yousef-chitani/Type_0_CNC/docs/decisions.md

# Decision log

| # | Decision | Reason |
|---|---|---|
| D-01 | Fixed gantry, table moves in Y | Stiffest layout for EG. Same as Bootstrap Bill |
| D-02 | Cast the EG at home | Cost |
| D-03 | Target accuracy ±0.02 mm | Realistic for DIY EG with good alignment |
| D-04 | ISO20 taper | Matches the chosen spindle. Light holders, compact rack |
| D-05 | Rack lives behind the gantry | Leaves the work area clear and away from chips |
| D-06 | Rack comes in low, through the table opening | During a tool change the table moves forward out of the way and the rack slides in under the spindle. No window in the beam, so Z stays short. X travel stays at the work size. Any Y overrun is to be checked in the layout (it depends on rack depth) |
| D-07 | Mist / MQL coolant, full enclosure | Works for alu and steel, with less mess than flood |
| D-08 | Z travel can drop below 250 mm | Small parts. A shorter Z overhang is stiffer. Value set in D-09 |
| D-09 | Z travel 150 mm, about 180–200 mm clearance | Fits a vise, a part and a long tool. Short overhang stays stiff. Enough lift to clear the rack forks |
| D-10 | C7 rolled ballscrews with preloaded double nuts (DFU) | Fits the budget. About ±0.05 mm per 300 mm, brought to ±0.02 mm with a mapping run and LinuxCNC screw compensation |
| D-11 | HGR20-pattern rails, Z1 preload | Plenty for this size. Rails will be checked and sorted on arrival |
| D-12 | Rail seats made with a self-leveling epoxy layer over cured EG, rails bolted to cast-in inserts | Cheap and good to about 0.01–0.02 mm if done carefully. No reference surface needed |
| D-13 | SFU1605 ballscrews, preloaded DFU nuts, on all three axes | Fine resolution and high thrust for steel. One screw and nut type for all axes. Rapids about 6–7 m/min, enough for small parts |
| D-14 | Direct drive through disc or bellows couplings | No backlash and nothing to tension |
| D-15 | NEMA 24 closed-loop steppers, about 4 Nm, on all axes | Margin for the heavy table and for steel |
| D-16 | Z motor has a built-in 24 V holding brake | Stops the spindle drifting down with the power off. Simplest and safest option |
| D-17 | Rack holds two rows of 4 ISO20 pockets at about 60 mm pitch | 4 × 60 mm fits within the 250 mm X travel. Keeps all 8 tools without widening the machine |
| D-18 | Rack driven by a small stepper on a screw or belt, run as a 4th joint in LinuxCNC with a home switch | Exact stop for each row and adjustable in software. Doesn't depend on air pressure |
| D-19 | Tool-length sensor on the rack carrier | Protected from chips and takes no table space. Measures each tool right after pickup |
| D-20 | Y: 2 rails about 220 mm apart, 2 carriages per rail, about 150 mm apart along Y | Wide stance resists cutting moments. Room for the screw between the rails |
| D-21 | X: 2 rails on the gantry front face, about 150 mm apart vertically, screw between them | Only one face to level-pour. Simple and proven on DIY gantries |
| D-22 | Z: rails on the moving spindle plate, blocks fixed on the X saddle | Compact, light saddle. Fine for 150 mm of travel |
| D-23 | Table: 25–30 mm aluminium tooling plate with a threaded M6/M8 grid, about 320 × 320 mm | Light, cheap, can be surfaced on the machine. Suits small fixtured parts |
| D-24 | Separate EG castings (base; gantry), bolted and epoxy-bonded | Smaller molds, each about 60–150 kg, so easier to vibrate and handle. The gantry can be squared to the Y rails before bonding |
| D-25 | Molds made of melamine-faced MDF/ply with packing tape, wax and PVA release | Cheap, flat, easy to cut. Good for one-off castings |
| D-26 | Graded aggregate mix with about 10–12% epoxy by weight | Kiln-dried quartz gravel, sand and fine filler following a packing curve, with low-viscosity casting epoxy. Less epoxy means less cost, less heat and less shrinkage |
| D-27 | Compact on a sprung vibration table driven by unbalanced motors | Even compaction, no voids, reusable for every casting |
| D-28 | Rail and pad fixings are steel insert bars (40×10 mm, tapped), bolted to the mould floor during the pour | Holes stay in line at the rail-bolt pitch and can't drift during vibration |
| D-29 | Gantry joins the base with M12 bolts plus a grout layer: shim the gantry square, inject epoxy grout, tighten after cure | Square and stiff, and the joint isn't stressed while it cures |
| D-30 | Solid castings (no cores) | No documented DIY example of large foam cores was found. Solid is the most proven. Cost: about 315 kg and about 41 kg of epoxy. Curing heat must be managed (see eg-moulds.md) |
| D-31 | Mesa 7i76EU (Ethernet) as the only interface board | 5 step/dir (4 used, 1 spare), 32 inputs and 16 outputs cover the about 20 inputs and 10 outputs needed, with room to spare |
| D-32 | Spindle VFD controlled over Modbus RS-485 (via the 7i76EU's RS-485 port, D-58) | Speed command plus readback of actual speed, faults and load. Lets LinuxCNC confirm the spindle has stopped before releasing a tool |
| D-33 | Water-cooled spindle, with a flow switch interlocked into LinuxCNC | Quiet and doesn't stir up dust in the enclosure. The spindle can't run without coolant flow |
| D-34 | x86 mini-PC with an Intel network port dedicated to the Mesa board | Reliable timing, cheap used |
| D-35 | Hardwired e-stop: buttons and the Mesa watchdog run through a safety relay that drops a contactor, cutting drive power and the VFD run signal | Still stops if the PC or software crashes. The Z brake engages when power drops. LinuxCNC only reads status |
| D-36 | One 48 V DC supply (about 10 A) for all 4 stepper drivers | Keeps torque up at speed. The rack driver must accept 48 V |
| D-37 | Electrical cabinet built into the stand, underneath the machine | Owner's choice: compact. Mitigations: sealed steel box with a sloped drip lip above it, filtered fan blowing air in (keeps dust and mist out), raised off the floor, away from the coolant drain, VFD mounted at the top with heat vented clear of the drives, door reachable from the front |
| D-38 | CW-3000-style radiator unit for the spindle water loop, using its flow alarm output for the interlock | Plenty for 2.2 kW, cheap. Confirm the model has a flow alarm output before buying |
| D-39 | Spindle: Jianken JGL-80/2.2R24-20 (24,000 rpm, 400 Hz, 220 V, ISO20, water-cooled), with clamp/unclamp sensors | About 0.87 Nm vs about 0.70 Nm for the R30 version, so about 25% more torque at every working speed. Better for steel and brass. Sources: [Jianken manual (LinuxCNC forum)](https://forum.linuxcnc.org/media/kunena/attachments/27367/OperationManual2019.pdf), [Amazon listing](https://www.amazon.com/LVSEDTAL-JGL-80-2-2R24-20-24000rpm-Spindle/dp/B0F5HKDVV4) |
| D-40 | ISO20-ER16 tool holders (8) | Owner's choice: cutters up to 10 mm |
| D-41 | Z motor: StepperOnline 24HS34-5004D-E1000-B280 (3 Nm closed-loop with 2.8 Nm 24 V brake) on a CL57T driver | Same frame, maker and driver as X and Y. 3 Nm is plenty for Z: holding the spindle needs only about 0.1 Nm through a 5 mm lead |
| D-42 | Precision level 0.05 mm/m (Dasqua 200 mm, £68.50) instead of 0.02 mm/m (£333.72) | The rail seats level themselves in one linked pour. The level only sets the casting and stand roughly level. Saves £265.22 |
| D-43 | Prefer collecting materials in person from B&Q (Nissan Qashqai) | Owner's preference: avoids delivery costs. Aggregates must still be clean and dry |
| D-44 | Molds from plain 18 mm MDF (Wickes, 3 sheets), faces and edges sealed, then wax + PVA | Saves £286.20 over the melamine 5-pack |
| D-45 | Fine aggregate: B&Q kiln-dried sand 2 × 25 kg, sieve-checked | Saves £152.42. Already dry and washed |
| D-46 | Coarse and medium aggregate: washed, kiln-dried resin-bound quartz from GCL (2-5 mm and 1-3 mm) | Graded and dried for resin use. Horticultural grit and the Rugeley collection were declined. Pallet delivery cost to Swansea still to confirm |
| D-47 | Build in two stages. Stage 1: frame, motion, spindle, electronics, air, stand: a working mill with manual tool changes (air release button). Stage 2: tool rack and its drive, enclosure, mist, door interlock | Spreads cost and gets the machine cutting sooner. The frame already includes the rack zone and inserts, so stage 2 bolts on |
| D-48 | Layout as a parametric CadQuery script producing STEP + dimensioned SVG views | One set of numbers drives the model, drawings and cut lists |
| D-49 | Table top about 950 mm above the floor | Comfortable standing height; cabinet fits under |
| D-50 | Y motor at the front, X motor on the right | Keeps the rear rack zone clear |
| D-51 | Design workholding height about 100 mm (small precision vise) | Sets Z clearance and gantry opening height |
| D-52 | Layout draft 1 accepted as the working basis: Y travel 395 (250 + 145 for the tool change), base 970 × 660 × 180 | Generated from cad/type0_layout.py, see layout.md |
| D-53 | Electrical cabinet inside the stand, max 440 mm tall: prefer 600 W × 400 H × 200 D (fallback 400 × 400 × 200) | Fits between the stand rings. The wider box leaves room for VFD heat and wiring |
| D-54 | Stand from 60 × 60 × 3 box section with diagonal bracing (about 11.9 m) | Ample for about 400 kg when braced. Cheaper and lighter than 80 × 80 × 5 |
| D-55 | Rails from Kaiyade (3 kits in one order), ballscrews X 450 / Y 550 / Z 350 from METALWORK, 60 × 60 × 3 steel from eBay (6 × 2 m), 600 × 400 × 200 galvanised cabinet | Cheapest full matches without per-shopper deal limits |
| D-56 | Cast a Y-screw channel about 70 × 25 mm into the base between the Y rails | The DSG16H housing hangs 10 mm below the base top when bolted under the table |
| D-57 | Budget: Stage 1 £5,300, Stage 2 £600 | Priced Stage 1 is £4,807 plus the Mesa board, spindle import VAT and aggregate delivery. Margin for shipping and surprises |
| D-58 | Owner supplies: mini-PC, monitor/keyboard/mouse, 3D-printed ISO20 forks. No 2nd NIC, no USB-RS485 adapter | PC stays offline, so the onboard Intel NIC runs the Mesa. VFD Modbus runs on the 7i76EU's own RS-485 port |
| D-59 | All power supplies DIN-rail Mean Well: 48 V (≥ 10 A), 24 V (HDR-150-24), plus a low-wattage 5 V | Saves cabinet space. Mounts on the same DIN rail |
| D-60 | Mesa 7i76EU at €309.31 (owner-confirmed) | Owner's price check |
| D-61 | Moulds: 1 B&Q MDF sheet (£28) for both floors (sealed + coated), 2 B&Q white gloss panels (£38.97 each) for walls and plug. Replaces D-44 | No seam in the precision floor face. Gloss walls need no sealing |
| D-62 | Owner orders the spindle direct from Jianken. The Mesa £257.74 already includes import VAT (not yet bought) | Owner action |
| D-63 | Aggregates: GCL washed kiln-dried quartz 2-5 mm (6 × 25 kg) for coarse. Hancock & Brown kiln-dried 0-1 mm sand (8 × 20 kg) for medium/fine. H&B limestone dust (dried) for filler. Replaces D-45, D-46 | Only the filler needs drying. Ready-to-use coarse. Local collection for the sand |
| D-64 | Filler: pottery whiting 25 kg (Valentine Clays, £20.42) instead of limestone dust | Bought dry, so no oven drying. Cheaper than silica flour and less hazardous to breathe |
| D-65 | Cuts: DIY vibrator, DIY temperature logging, MDF for mould walls (2 sheets total), DIY spindle cooling loop, cheaper stand | Owner's choices to reach about £4,000 |
| D-66 | Three phases. **Phase 1:** frame, motion, electronics, 2.2 kW water-cooled ER20 spindle (manual tool changes). **Phase 2:** Jianken ISO20 ATC spindle + holders, air system, mist, enclosure. **Phase 3:** tool rack, its drive, forks. Replaces D-47 | Spreads the cost. ER20 and ATC spindles share the 80 mm clamp, VFD and cooling loop |
| D-67 | UHPC frame rejected after costing: IN2 €67.50 ex VAT / 25 kg (11.7 L) needs about 13 bags (about €877). Polcrete about £45.60 / 20 kg (about 16 bags, about £730). Epoxy granite stays | Not cheaper in the UK at retail (Bootstrap Bill's about 50 CAD bags are Canadian prices) |
| D-68 | Budget: Phase 1 ≤ £4,000. Phases 2 and 3 budgeted later. Replaces D-57 | Owner target |
| D-69 | Phase 1 replacements: Wanhongcnc 2.2 kW ER20 spindle £150.59; ER20 collets + spanner £34.49; 24 V DIY cooling loop £104.77; stand from 8 m of 60 × 60 × 3 (no lower ring) £136.00 | Budgeted at normal (non-deal) prices. Phase 1 total £3,638.39 |
| D-70 | Phase 1 spindle from a known maker only: Jianken JGD-80 2.2 kW ER20, quoted together with the ATC spindle. Replaces the Wanhongcnc choice in D-69 | Unknown makers risk poor runout |
| D-71 | **Scale-down (v2):** upstairs flat, pieces ≤ 40 kg, total about 150 kg on anti-vibration feet, work area 200 × 200 × 150, coolant only inside an enclosure, timber bench made by the owner. Frame stays cast epoxy granite (no welded frame: weld stress) | Owner must be able to move out and keep it indoors |
| D-72 | If ATC is added, the rack (2 × 4) bolts to the table's +X side: table Y travel selects the pocket, spindle X travel extends by about 140 mm. No extra Y travel | Keeps the Y spine short and under 40 kg |
| D-73 | Portal legs span only the table (opening 320). Beam overhangs about 160 mm past the right leg. The ATC (if added) is an independent **ferris wheel**, 8 pockets, about Ø178, turning in the Y-Z plane beside the right leg, with the top pocket as the pickup. Replaces D-72 | Narrower, lighter portal. No rack on the table. X travel about 380 (200 work + reach) |
| D-74 | If the portal is over 40 kg, use capped PVC pipe cores in the beam (2 × 50 mm: about 34 → about 29 kg) | Documented DIY method (owner choice) |
| D-75 | v2 model accepted: castings 36.2 / 15.6 / 29.0 kg (80.8 kg). Travel X 380 / Y 200 / Z 150. Rails X 560, Y 400, Z 350. Screws X 550, Y 400, Z 350. Bench top 785 mm. Joints and wheel mount in v2-design.md | Rev B approved by owner |
| D-76 | Spine and rear foot cast as **one T-shaped base**, about 52 kg (2-person carry). Frame = 2 castings: base + portal | Owner: 2 people can carry it upstairs. Removes the only frame joint |
| D-77 | Vibration table: 1–2 old tyres as springs, a stiff board, and a motor with an unbalanced shaft. Replaces the vibration motors and rubber feet | Owner's method: cheap and proven |
| D-78 | Phase 1 spindle: **G-Penny 2.2 kW ER20 water-cooled kit** (£217.39) with Huanyang VFD, clamp, pump and collets. Replaces the Jianken JGD-80 (D-70) and the separate VFD, clamp and 24 V pump | Known maker, runout 0.005 mm stated, P4 angular-contact bearings, LinuxCNC has a Huanyang driver |
| D-79 | Work area **400 × 250**, Z 150 (fits 75% keyboards with room for fixtures). Table 460 × 330 × 25. Travel X 570 (incl. ATC reach) / Y 250 / Z 150 | Owner: wider range of work |
| D-80 | Y rails 280 mm apart on a 320 mm-wide spine (block pitch 150). Base about 72 kg, portal about 34 kg, frame about 106 kg | Table overhang about 90 mm per side instead of 140 |
| D-81 | Base mass accepted for now. Owner will run FEA later to find where material can be removed (ribs, cores) | Owner |
| D-82 | **Vendor policy:** no eBay. Use as few vendors as possible. Prefer B&Q and Screwfix (local), then RS Components. Target vendors: RS (all electrical, fixings, small metal, measuring tools), Screwfix + B&Q (building and casting consumables), Easy Composites (all epoxy + release), AliExpress (rails, screws, spindle kit, couplings, collets), StepperOnline (motors), Mesa, Aluminium Warehouse, aggregates | Owner: fewer baskets, local collection |
| D-83 | Threaded rod and nuts, conduit/tube and packing tape from AliExpress (not Screwfix). Any vendor swap that costs much more than the current price (more than 10% or £5) must be flagged before accepting | Owner: consolidation must not add a large premium |
| D-84 | Vendor consolidation applied (price check 8, logged in to AliExpress). Accepted premiums: Schneider XPSAC5121 safety relay (+£53.71), screened cables from AliExpress (+£21.95), RS cabinet 600 × 400 (+£43.09). Rejected: B&Q flat bar (keep The Metal Store £36), stainless M12 rod (price zinc at Screwfix). Level from AliExpress £32.94. 24 V PSU stays StepperOnline. E-stops 2 NC for the dual-channel relay. Epoxy: GlassCast 50 PLUS from Easy Composites | Owner choices on the price check 8 premiums |
| D-85 | Price check 9 applied: Screwfix BZP M12 rod 5-pack + nuts; AliExpress brass flow switch G1/4 (NO, 1.5–3 L/min); 8 mm ID braided PVC hose (B&Q marketplace); twinwall polycarbonate window (owner); RS push-in fittings; AliExpress shaft + KFL004 bearings; 5th LJ12 sensor added to E10. No eBay left | Last non-eBay sources |
| D-86 | Phase 3 (ATC wheel) merged into Phase 2. Now two phases: **Phase 1** working mill (manual ER20), **Phase 2** ATC spindle, air, mist, enclosure and the tool wheel. Replaces the phase split in D-66 | Owner |
| D-87 | Enclosure: 12 mm MDF box on the bench around the machine (not touching the castings), no bottom. Internal 880 × 930 × 742, outside 904 × 954 × 754. Top-hinged front door (622 high) above a 120 mm fixed strip; 560 × 380 twinwall window low in the door so the table and spindle tip are visible. 2 MDF sheets. Cable/hose slot with brush strip low in the back | Owner choices: top-hinged door, sits on bench, window in door |
| D-88 | Enclosure window: 4 mm solid clear polycarbonate 600 × 420 from plasticsheets.com, £29.87 delivered (+£5.88 vs twinwall). Replaces the twinwall in D-85 | Clear view, and 4 mm resists flying chips better than 3 mm |
| D-89 | Enclosure MDF from B&Q (12 mm, £23 per sheet × 2) instead of Wickes | One fewer vendor; cheaper |
| D-90 | Phase 1 runs 4 Jan 2027 → 22 Jul 2027 at about 5 h/week, built in the shed. Done = machine moves under LinuxCNC. Orders spread in 5 waves. Castings in April–May (≥ 18 °C cure). See phase1-schedule.md | Owner timeline |
| D-91 | Electrical design (docs/electrical.md): 13 A plug; 2 e-stops (bench front + cabinet door, 2 NC each, dual channel); home switches + soft limits (no hard limits); spindle on Modbus RS-485 only (7I76EU TB3, W6 termination off); 24 V supply powers the Mesa field + logic, never switched; one Mesa output enables all 3 drives; 5 V PSU shelved; DIN interface relay (24 V coil) for the 220 V pump | Owner answers + 7I76EU manual |
