yousef-chitani/Type_0_CNC/docs/price-check-task-9.md

# Price check task 9: last lines without a non-eBay source

**Project:** Type 0 CNC. Buyer in **Swansea, UK**. **Vendor policy (D-82/D-84):** no eBay. Use **only these vendors**, in this order of preference: **Screwfix, B&Q, RS Components, AliExpress, Easy Composites, StepperOnline, Aluminium Warehouse** (all already in the order). Do not add a new vendor unless nothing fits, and say so if you must.

## Rules
1. Only record prices you can **see on a live product page**. Never estimate or convert.
2. Record the price exactly as listed, VAT basis, pack size, shipping and delivery estimate. Screwfix and B&Q: stock and click & collect at the Swansea stores.
3. **AliExpress:** ask the person to log in themselves first, and wait. Never type, read or store their password or codes. Read prices logged in.
4. Do not add to basket, check out, buy or contact sellers. If a page asks for a human check, ask the person.
5. Compare each new all-in price with **Current** and report the delta: **OK** (≤ 10% or £5 above), **PREMIUM** (more, give the cheapest alternative too), **SAVING** (cheaper).
6. The product must match the spec. Say so if it only partly matches.

## Phase 1

| ID | Item | Spec | Current |
|---|---|---|---|
| F08 | M12 threaded rod + nuts | **Zinc-plated** M12 studding, 2 × 1 m, plus about 20–50 M12 nuts (Screwfix first) | none (old eBay price £28.74; stainless AliExpress £57.08 was rejected) |
| S05a | Coolant flow switch | **With switch contacts** (closes on flow), suits **8 mm** hose or 1/4"–1/2" BSP, switches at about 1–3 L/min, contacts rated for 24 V DC signal | none (old eBay £11.99) |
| S05b | Coolant tube | Silicone or PVC tube **8 mm ID** (about 11–12 mm OD), 5 m, for 8 mm barbs | none |

## Phase 2–3

| ID | Item | Spec | Current |
|---|---|---|---|
| N02 | Enclosure window | 4 mm clear polycarbonate, about 600 × 600 mm (B&Q/Screwfix sheet first) | £31.93 (eBay) |
| P06 | Push-in pneumatic fittings | 8 × straight 6 mm tube to 1/8" BSP male, 4 × straight 8 mm tube to 1/4" BSP male | £34.12 (eBay) |
| A07 | ATC wheel shaft + bearings | Ø20 mm steel shaft 150 mm (precision or bright), + 2 × UCFL204 / KFL004 2-bolt flange bearings, 20 mm bore | £29.49 (eBay) |
| A09 | Index sensor | M12 inductive, PNP NO, 24 V (LJ12A3-4-Z/BY or equal) | £4.99 (eBay). Note: E10 already buys this exact sensor on AliExpress: add 1 to that line if same price |

## Reply block

```
ID | vendor | price as listed (currency, VAT basis) | quantity it covers | stock / collect / shipping | product URL | all-in £ | current £ | delta (OK / PREMIUM / SAVING) | notes
```
Finish with the total for the Phase 1 lines and the total for the Phase 2–3 lines.
