yousef-chitani/Type_0_CNC/docs/price-check-task-7.md

# Price check task 7: parts resized for the 400 × 250 work area

Same rules as tasks 1–6: live product pages only, price exactly as listed, currency, VAT basis, UK shipping, deal limits and normal prices. Ask the person to solve any CAPTCHA. Do not sign in, add to basket, buy or contact sellers.

| ID | Item | New spec | Where to look |
|---|---|---|---|
| M02 | HGR20 rail kit, X | 2 × **800 mm** HGR20 + 4 × HGH20CA | MHCN https://www.aliexpress.com/item/1005010242098397.html (also Kaiyade https://www.aliexpress.com/item/1005009213173130.html , note shipping per item) |
| M05x | DFU1605 ballscrew kit, X | **750 mm** (overall), DFU1605 double nut, machined ends, BK12/BF12, nut housing, coupler | METALWORK https://www.aliexpress.com/item/1005010046279521.html (also note whether listing lengths are overall or thread) |
| M11 | Table plate | 6082 aluminium **460 × 330 × 25 mm** custom cut (also price cast tooling plate) | https://www.aluminiumwarehouse.co.uk/products/25-mm-6082-aluminium-plate |
| N01 | Enclosure MDF | 12 mm MDF sheets for a box about **950 W × 850 D × 700 H** (2 sides, back, front with window opening, top): how many 2440 × 1220 sheets, and price | Wickes https://www.wickes.co.uk/General-Purpose-MDF-Sheet---12-x-1220-x-2440mm/p/110034 |

```
ID | price as listed (currency, VAT basis) | quantity it covers | shipping / delivery | product URL | notes
```
