yousef-chitani/Type_0_CNC/docs/price-check-task-6.md

# Price check task 6: v2 (flat-sized) parts (for a local Claude session with a browser)

**Project:** Type 0 CNC v2, a small epoxy-granite mill for a flat. Buyer in **Swansea, UK**. **Goal:** confirmed prices for the resized parts below.

## Rules
1. Only record prices you can **see on a live product page** (select the size option and read the price). Never estimate or convert currency.
2. Record price exactly as listed, currency, VAT basis, UK shipping and delivery estimate. Note deal limits and normal prices.
3. **If AliExpress shows a CAPTCHA**, stop and ask the person to solve it in the browser pane.
4. Do not sign in, add to basket, buy or contact sellers. `NOT FOUND` with the reason if no live price.
5. Cheapest full match, plus one better-rated option in notes.

## Phase 1 (priority)

| ID | Item | Spec | Where to look |
|---|---|---|---|
| M01 | HGR20 rail kit, Y | 2 × **400 mm** + 4 × HGH20CA | Kaiyade https://www.aliexpress.com/item/1005009213173130.html (check that the £79 shipping is per order) |
| M02 | HGR20 rail kit, X | 2 × **560 mm** (or 600 if 560 is not offered) + 4 × HGH20CA | same listing |
| M11 | Table plate | 6082 aluminium **280 × 280 × 25 mm**, cut to size (also price cast tooling plate) | https://www.aluminiumwarehouse.co.uk/products/25-mm-6082-aluminium-plate if it exists, else search their 25 mm plate |
| M12 | Saddle + Z plate | 6082 aluminium 20 mm: **180 × 160** and **140 × 320** | https://www.aluminiumwarehouse.co.uk/products/20-mm-6082-aluminium-plate |
| T02 | Anti-vibration levelling feet × 4 | M10 or M12 stud, rubber base, rated **≥ 50 kg each** (load stated), for a timber bench | eBay UK, AliExpress, Screwfix/Toolstation |

## Phase 2–3 (if time)

| ID | Item | Spec |
|---|---|---|
| N01 + N02 | Enclosure | Internal about **760 W × 780 D × 700 H** mm. Cheapest of: 20 × 20 or 30 × 30 aluminium extrusion frame + 4 mm polycarbonate, **or** MDF/plywood box with one polycarbonate window. Give materials and prices |
| A06 | ATC wheel discs + bracket | Aluminium plate 8 mm, 2 × Ø200 (or 2 × 200 × 200 squares) + 1 × 150 × 120 × 10 bracket |
| A07 | Shaft + bearings | Ø20 precision shaft 150 mm + 2 × UCFL204 / KFL004 flanged bearings |
| A08 | Belt reduction | GT2 20T + 60T pulleys (5 mm / 20 mm bores) + GT2 closed belt to suit about 70 mm centres |
| A09 | Index sensor | M8 or M12 inductive PNP NO, 24 V |

## Reply block

```
ID | price as listed (currency, VAT basis) | quantity it covers | shipping / delivery | product URL | notes
```
