yousef-chitani/Type_0_CNC/docs/price-check-task-5.md

# Price check task 5: Phase 1 replacements (for a local Claude session with a browser)

**Project:** Type 0 CNC, a DIY epoxy-granite mill. Buyer in **Swansea, UK**. Phase 1 now uses a plain ER20 spindle, a DIY cooling loop and a cheaper stand. **Goal:** confirmed prices for the items below.

## Rules
1. Only record prices you can **see on a live product page**. Never estimate or convert currency.
2. Record the price exactly as listed, with currency, VAT basis, UK shipping and delivery estimate. Note deal limits and normal prices.
3. **If AliExpress shows a CAPTCHA**, stop and ask the person to solve it in the browser pane, then continue.
4. Do not sign in, add to basket, buy or contact sellers. `NOT FOUND` with the reason if no live price.
5. Report the cheapest full match, plus one better-rated option in notes.

## Items

| ID | Item | Spec to match | Notes |
|---|---|---|---|
| S08 | Spindle (spindle only, no VFD) | **2.2 kW, water-cooled, 80 mm body, 220 V, 400 Hz, 24,000 rpm, ER20** | Must match the existing VFD (220 V 3-phase, 0–600 Hz) and 80 mm clamp. Check UK/EU warehouse options too |
| S09 | ER20 collet set | Precision (AA or better) ER20 set, about 1–13 mm, plus spanner if not with spindle | |
| S05a | Coolant pump | 12 or 24 V DC, about 6–10 L/min, head ≥ 3 m, suitable for continuous use | e.g. DC brushless "solar"/PC water pump |
| S05b | Radiator + fan | Aluminium or copper radiator, about 240 mm, with 12/24 V fan(s), G1/4 ports | PC water-cooling style |
| S05c | Reservoir | About 1–2 L, G1/4 or barbed ports | |
| S05d | Flow switch | **With contact output** (switch closes on flow), G1/4 or 1/2", works at about 2–5 L/min | Needed for the spindle interlock |
| S05e | Hose + fittings | 8 mm ID tube (about 5 m) + barbs/clamps to suit spindle ports (check the spindle listing) | |
| T01a | Used heavy steel bench / welding table, South Wales | Top about 700 × 1,000 mm or larger, rigid, rated or clearly able to carry ≥ 400 kg, height about 700 mm (or adjustable). eBay UK (collection near Swansea) | List 2–3 options with location |
| T01b | 60 × 60 × 3 box section, **8 m** (reduced cut list: no lower ring, braces only) | eBay seller 128036584011 2 m lengths, or BM Steel | Price per length and the total for 8 m |

## Reply block (output exactly this format)

```
ID | price as listed (currency, VAT basis) | quantity it covers | shipping / collection, delivery estimate | product URL | notes
```

Finish with the **Phase 1 extra total** (S08 + S09 + S05a–e + the cheaper of T01a/T01b).
