yousef-chitani/Type_0_CNC/docs/aggregates.md

# Aggregates: sourcing (owner prefers collection)

Need about **300 kg** in total for solid castings (layout: 298 kg at 89%) plus test bricks. Draft split (to be tuned in the mix design):

| Fraction | Size | Amount |
|---|---|---|
| Coarse | 2–5 mm (or up to about 10 mm, see below) | about 135–150 kg |
| Medium | about 0.5–2 mm | about 90–100 kg |
| Fine | 0.1–0.5 mm | about 45–50 kg |
| Filler | < 0.1 mm | about 25–30 kg |

**Everything must be clean (no clay or silt) and completely dry before mixing.** Damp or dusty aggregate weakens the epoxy bond.

## Options

| Source | What | Status |
|---|---|---|
| **Gravel Works Ltd**, Prospect Park, Fforestfach, Swansea SA5 4ED, 01792 677187, sales@gravelworks.co.uk ([site](https://www.gravelworks.co.uk/aggregates-and-soil-swansea-carmarthenshire)) | Sharp sand, soft washed sand, 10 mm clean stone, stone dust (limestone or granite), pick-up or delivery | **No prices online: phone for a quote** |
| B&Q (collect) | Verve horticultural grit £6 / 20 kg (spec not stated); kiln-dried sand bags (some click and collect) | Needs wash / dry / sieve for the grit |
| GCL (delivered) | Washed, kiln-dried quartz 2–5 mm £14.52 / 25 kg, 1–3 mm £16.15 / 25 kg | Ready to use. Pallet delivery cost unknown |

## Questions to ask Gravel Works
1. What is the **10 mm clean stone** and the **stone dust**: granite, limestone or something else? (Granite or quartz is best. Limestone works but is softer.)
2. Do you have a **washed grit or chippings 2–6 mm** (or 4–10 mm)?
3. Is the **sharp sand washed**, and roughly what size range (usually 0–4 mm)?
4. Do you sell **small quantities for collection** (bags or a part bulk bag): about 150 kg coarse + 100 kg sand?
5. Price for collection.

## If using local damp material
- **Coarse:** 10 mm clean stone is usable for a 180 mm base (keep the max size under about 1/5 of the thinnest section). It shifts the grading coarser, which can lower the epoxy needed. Washed 2–6 mm grit is better around the inserts.
- **Medium:** washed sharp sand, sieved to remove anything over about 2 mm.
- **Fine:** B&Q kiln-dried sand (already dry).
- **Filler:** silica flour (Potterycrafts) or granite stone dust, if it is dry and clay-free.
- **Drying:** spread thinly and dry, then finish in an oven at about 100–120 °C, or a hot day plus a few days under cover. Check by weighing a sample before and after oven drying: there should be no weight loss.
- **Kit:** 2 mm and 5 mm sieves (add to the BOM if this route is chosen).

## Decision (D-63)
- **Coarse:** GCL Winter Quartz 2–5 mm, 6 × 25 kg, washed and kiln-dried (delivered).
- **Medium and fine:** Hancock & Brown kiln-dried pavior sand 0–1 mm, 8 × 20 kg (collect: confirm on 01792 462346).
- **Filler (D-64):** pottery whiting, 25 kg, from Valentine Clays (£20.42), bought dry. Replaces the limestone dust (drying fine dust at home is impractical).
- The 1–2 mm gap is acceptable (gap-graded). Test bricks will show the epoxy demand. If it is too high, add 2 bags of GCL 1–3 mm.

Other local option on file: Hancock & Brown 6 mm limestone chippings £4.74 / 25 kg (needs washing and drying).

## Whiting datasheet (Valentine Clays, owner-supplied)
- Moisture 0.1% ex works: use as supplied, no drying.
- d50 9 µm, top cut (d98) 110 µm, 4% retained on 53 µm, 19% below 2 µm.
- SG 2.7, 99% CaCO₃, pH 9, oil absorption 17 g/100 g, Blaine 480 m²/kg.
- **Limit to about 8–10% of the aggregate mass.** The very fine part raises viscosity and epoxy demand. Tune on test bricks.
- Paper bags: decant into a sealed tub once opened. Warm before use if stored in a damp garage.
