yousef-chitani/Type_0_CNC/docs/epoxy-options.md

# Epoxy options (UK)

We need about **41 kg** in total (see [eg-moulds.md](eg-moulds.md)). There are two separate jobs:

1. **Bulk EG binder** (about 37 kg). Low viscosity, so it wets fine filler well. Curing heat matters less here, because the aggregate (about 89% of the mass) soaks up the heat. Clear, UV-stable resin isn't needed.
2. **Rail-seat leveling pour** (about 3 kg). Very low viscosity and a slow cure, so it has time to settle flat. Low shrinkage. Poured only 3–5 mm deep.

| Product | Supplier | Kit | Price | £/kg | Notes |
|---|---|---|---|---|---|
| Ampreg 30 + slow hardener | EC Fibreglass Supplies (Gurit) | 22.68 kg | £295 (page doesn't say whether VAT is included) | about £13 | Structural laminating epoxy with low viscosity. Several hardener speeds. **Cheapest per kg for the bulk EG.** |
| GlassCast 50 PLUS | Easy Composites | 5 / 15 / 30 kg | from £76.46 + VAT (5 kg) | about £15 + VAT | Viscosity about 300 mPa·s, slow cure (about 7 days to initial cure at 20 °C), deep pours up to 50–80 mm. **Good choice for the leveling pour.** |
| PureCast Slow | CFS Fibreglass | 21.75 kg | £348 (page doesn't say whether VAT is included) | about £16 | 2:1 mix, 17 h pot life, 10–50 mm pours. Viscosity not listed |
| West System 105 + 209 extra slow | Several | — | not confirmed | not confirmed | The usual UK forum pick for leveling pours and EG. Proven, but costly |

## Suggested plan (to confirm)

- **Bulk EG:** Ampreg 30 with the slow hardener, about 37 kg (two 22.68 kg kits). **2 × £295 listed = £590**, VAT basis to confirm.
- **Leveling, grout and samples:** GlassCast 50 PLUS, 5 kg. **£76.46 + VAT listed = £91.75 inc. VAT.**
- **Total: £681.75 from listed prices**, plus VAT on the Ampreg if the listed price excludes it.

Before committing, make 3–4 test bricks (about 150 × 150 × 100 mm) at 10%, 11% and 12% epoxy. Check for voids, surface finish and how they break.

## Pricing rule

Only prices read from a live supplier page are listed, with the date checked. Anything unconfirmed is marked *not confirmed*.

## Still to check

- Get the technical data sheets: mixed viscosity, pot life at 20 °C, and shrinkage.
- Ask suppliers whether the resin is suitable for **highly filled mineral casting**.
- Prices and VAT status were read from supplier pages on 2026-11-04 and may change.

Sources: [EC Fibreglass, Ampreg 30](https://ecfibreglasssupplies.co.uk/ampreg-30-low-viscosity-epoxy-resin-slow), [Easy Composites, GlassCast 50 PLUS](https://www.easycomposites.co.uk/glasscast-50-plus-clear-epoxy-casting-resin), [CFS, PureCast Slow](https://www.cfsnet.co.uk/pl-14867/purecast-slow-epoxy-kits/), [MyCNCUK, self-leveling epoxy thread](https://www.mycncuk.com/threads/3878-Self-levelling-epoxy-resin?p=121678).
