yousef-chitani/Type_0_CNC/cad/out/dimensions.md

# Type 0 layout: key dimensions (generated)

Generated by `cad/type0_layout.py`. Edit the parameters there and rerun. Sizes marked VERIFY in the script are catalogue assumptions.

## Travel
| | mm |
|---|---|
| X travel | 250 |
| Y travel, work | 250 |
| Y overtravel for tool change | 145 |
| **Y travel, total** | **395** |
| Z travel | 150 |

## Heights above base top
| | mm |
|---|---|
| Table top | 60 |
| Spindle nose, top / bottom | 260 / 110 |
| Rack fork plane | 140 |
| Gantry opening (beam underside) | 260 |
| Beam top | 460 |

## Castings (solid EG)
| | Size (mm) | Mass |
|---|---|---|
| Base | 660 W x 970 L x 180 H | 265 kg |
| Gantry | 640 W x 160 D x 460 H, opening 400 x 260 | 70 kg |
| Epoxy at 11% | | 37 kg |
| Aggregate at 89% | | 298 kg |

## Rails and screws (minimum lengths)
| Axis | Rail | Ballscrew |
|---|---|---|
| X | 2 x 448 | 405 |
| Y | 2 x 622 | 550 |
| Z | 2 x 328 | 305 |
| Rack slide | 2 x 545 (MGN15) | 495 (SFU1204), stroke 395 |

## Stand
| | |
|---|---|
| Base top above floor | 890 mm |
| Stand top above floor | 710 mm |
| Footprint | 700 x 1,010 mm |
| top ring | 3,180 mm |
| lower ring | 3,180 mm |
| legs (4) | 2,480 mm |
| diagonal braces: 2 sides + rear (est.) | 3,018 mm |
| **60x60x3 total** | **11.9 m** |
| Clear height between rings (cabinet) | 440 mm |
