yousef-chitani/Type_0_CNC/cad/v2/out/enclosure_cutlist.md

# Enclosure (D-87): cut list and notes

Generated by `cad/v2/enclosure.py`.

**Internal:** 880 W × 930 D × 742 H mm. **Outside:** 904 × 954 × 754 mm (sits on the bench, no bottom panel).

| Panel (12 mm MDF) | Size (mm) | Qty |
|---|---|---|
| Top | 904 × 954 | 1 |
| Back | 904 × 742 | 1 |
| Side | 930 × 742 | 2 |
| Front fixed strip | 904 × 120 | 1 |
| Door (top-hinged) | 904 × 622 | 1 |

Panel area about 3.59 m². One 2440 × 1220 sheet is 2.98 m², so **2 sheets** allowing about 15% for cutting.

**Window:** 560 × 380 cut-out in the door, covered by a 600 × 420 × 4 mm solid clear polycarbonate panel (D-88) screwed over it from inside with a foam or rubber seal strip.

## Fittings (not yet priced)
- Piano hinge, about the door width, along the top edge (door to top panel).
- 2 gas struts (about 100–150 N each, sized for the door weight) or a fold-down stay to hold the door open.
- Door handle and a magnetic catch.
- Door interlock: the E15 switch (already in Phase 2), wired to stop the spindle when the door opens.
- Brush strip or rubber grommets for a cable and hose slot in the back, low down, to the cabinet under the bench.
- Seal the inside with 2–3 coats of varnish or paint (MDF swells with coolant mist). Silicone the inside corners.
- Foam tape along the bottom edges to seal against the bench top.

## Notes
- The box does not touch the castings, so it carries no vibration and lifts off in one piece for moving (about 20–25 kg of MDF).
- The spindle top at full Z sets the height. The tool wheel side sets the width.
- Mist coolant (Phase 2): consider a small extraction outlet in the back panel later.
