yousef-chitani/Type_0_CNC/cad/v2/out/dimensions_v2.md

# Type 0 v2: key dimensions (generated)

From `cad/v2/type0_v2.py`. Z = 0 is the top of the spine/foot castings.

| | |
|---|---|
| Travel X / Y / Z | 570 (400 work + reach to the ATC wheel) / 250 / 150 |
| Table | 460 x 330 x 25, top at Z 55 |
| Spindle nose top / bottom | Z 235 / 85 |
| Gantry opening | 500 wide x 225 high. Beam top Z 355 |
| ATC wheel | dia 178, 8 pockets, pickup at X 370, fork plane Z 95 |

## Castings
| Casting | Size (mm) | Mass |
|---|---|---|
| Base (T-shape: spine 320 wide x 660 long, rear cross-piece 640 x 230), 110 high | one piece, 2-person lift | 72.1 kg |
| Gantry portal (2 x 50 mm PVC cores) | 800 W x 355 H x 130 D | 34.4 kg |
| **Total** | | **106.4 kg** |
| Epoxy at 11% / aggregate at 89% | | 11.7 / 94.7 kg |

## Rails and screws (minimum)
| Axis | Rail | Screw |
|---|---|---|
| X | 2 x 748 | 725 |
| Y | 2 x 478 | 405 |
| Z | 2 x 318 | 305 |

## Bench
Bench top 785 mm above the floor (table top at 950). Machine footprint about 840 x 780 mm.
