yousef-chitani/Type_0_CNC/cad/out/drawing_front.png

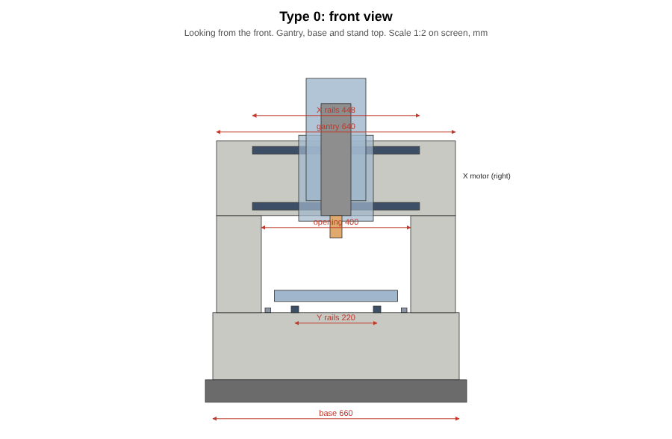
cad/out/drawing_front.png
