yousef-chitani/Type_0_CNC/cad/out/drawing_side.png

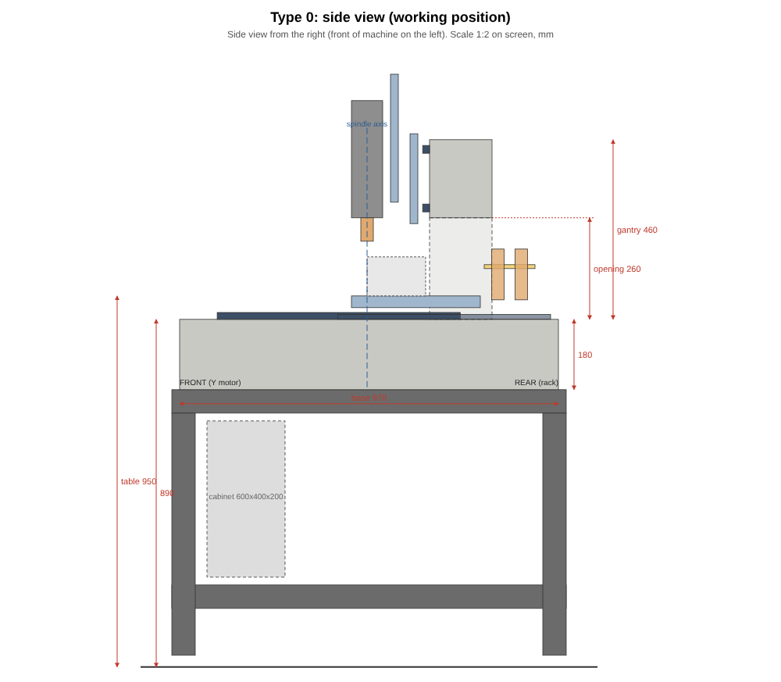
cad/out/drawing_side.png
