yousef-chitani/Type_0_CNC/cad/v2/out/enclosure_front.png

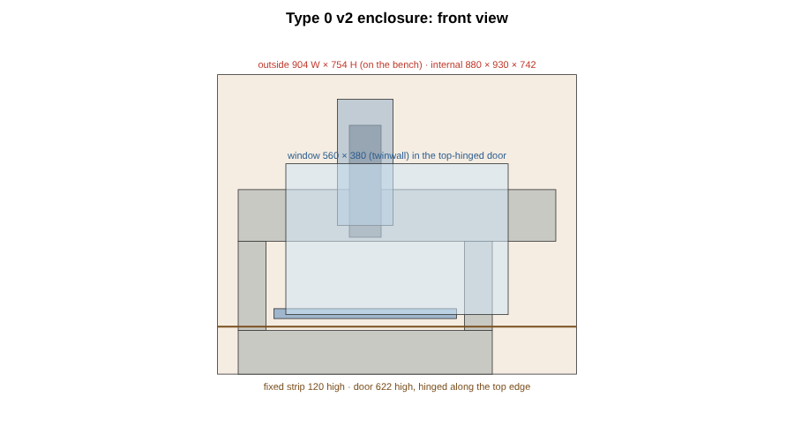
cad/v2/out/enclosure_front.png
