yousef-chitani/Type_0_CNC/cad/v2/out/sketch_front.png

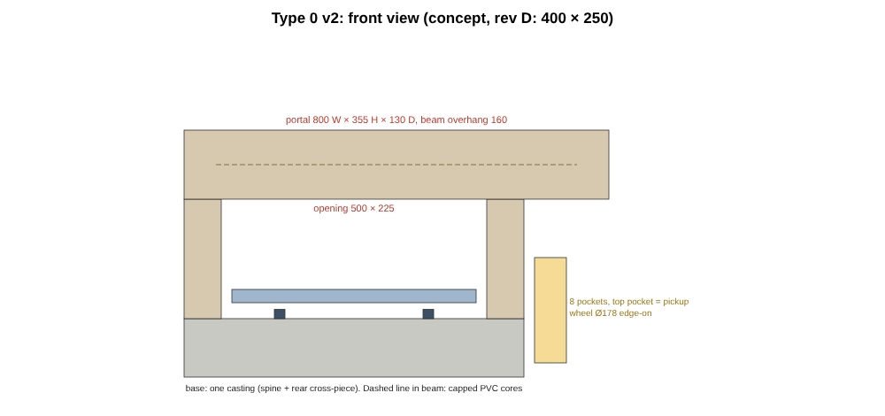
cad/v2/out/sketch_front.png
