yousef-chitani/Type_0_CNC/cad/v2/out/sketch_top.png

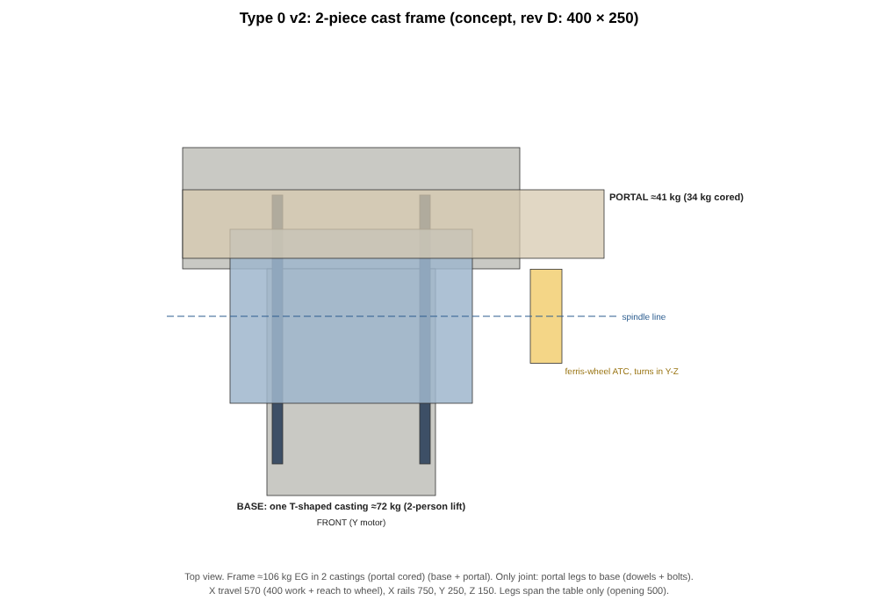
cad/v2/out/sketch_top.png
