yousef-chitani/Type_0_CNC/docs/bom.md

# Bill of materials (summary)

Full list: [bom.csv](bom.csv). **83 line items, 82 priced.** Prices were read from live pages on 2026-11-04/05 (by this session and a local browser session).

**Pricing rule:** `price_listed` is exactly what the page showed. `price_gbp` is the GBP line total (all units + listed shipping), inc VAT where known. Lines marked *VAT?* may get VAT added, and import VAT may apply to non-UK orders. EUR/USD prices are not converted.

| Subsystem | Line items | Priced | GBP total |
|---|---|---|---|
| Frame | 17 | 17 | £637.12 |
| Motion | 14 | 14 | £1,004.77 |
| Spindle | 9 | 9 | £1,546.00 |
| Tool changer | 7 | 7 | £154.46 |
| Pneumatics | 6 | 6 | £110.22 |
| Electronics | 21 | 20 | £810.62 |
| Enclosure | 3 | 3 | £78.61 |
| Stand | 2 | 2 | £12.19 |
| Metrology | 2 | 2 | £50.17 |
| Fixings | 2 | 2 | £70.47 |
| **All** | **83** | **82** | **£4,474.63** |

**Budget (D-68): Phase 1 ≤ £4,000. Phases 2 and 3 later.** Priced total: **£4,474.63**. Not priced yet: E23.

## Phase totals (D-66, D-86)
| Phase | What | GBP priced |
|---|---|---|
| 1 | Frame, motion, electronics, ER20 spindle, cooling, stand | £3,050.76 |
| 2 | ATC spindle + holders, air, mist, enclosure, tool wheel (D-86) | £1,423.87 |

Lines still TO PRICE: see the list above.

## Ten biggest lines
| ID | Item | £ |
|---|---|---|
| S01 | Jianken JGL-80/2.2R24-20 ATC spindle | 990.57 |
| S08 | G-Penny 2.2 kW ER20 water-cooled spindle kit | 318.16 |
| E01 | Mesa 7i76EU | 257.74 |
| F01 | Main EG epoxy: GlassCast 50 PLUS 15 kg | 255.00 |
| M11 | Table plate 6082 460 × 330 × 25 | 221.33 |
| M05 | DFU1605 ballscrew kits X 750 / Y 450 / Z 350 | 214.81 |
| E04 | 48 V PSU Mean Well SDR-480-48 (DIN) | 136.06 |
| M09 | NEMA 24 closed-loop stepper + driver about 4 Nm | 112.71 |
| E12 | Electrical cabinet RS PRO 600 × 400 × 200 IP66 | 109.04 |
| F02 | Epoxy for leveling pour / grout / samples | 91.75 |

## Warnings
- **Not in the total yet:** spindle import VAT (if not collected at checkout), GCL pallet delivery, vibration table top sheet.
- **S01 spindle:** UK import VAT (20%) is likely on top unless Alibaba collects it at checkout. Torque on the page says 0.7 Nm vs 0.87 Nm elsewhere: confirm.
- **M01–M03 rails:** sale price limited to 1 per shopper. At list prices the three kits are £387.63 (+£202.52).
- **S06 holders:** £6.05 may be a new-shopper price. At list price 8 holders are £178.96 (+£130.56). Pull stud must match the spindle.
- **Still to confirm with sellers:** S05 chiller alarm output, S02 VFD RS-485, GCL pallet delivery cost to Swansea (F03/F04).
- **F01 epoxy:** hardener probably included in the ECF packs: confirm by phone.
- **Reference sizes:** M12, A06, N02 and T01 are priced at placeholder sizes until the layout is drawn.

## Full list with links

| ID | Stage | Item | Qty | Spec | Link | Listed price | Line £ | Notes |
|---|---|---|---|---|---|---|---|---|
| F01 | 1 | Main EG epoxy: GlassCast 50 PLUS 15 kg | 1 kit | GlassCast 50 PLUS 15 kg: about 300 mPa·s mixed, pot life about 2 h at 20 °C, 69:31 by weight, slow cure (7 days) | [product](https://www.easycomposites.co.uk/glasscast-50-plus-clear-epoxy-casting-resin) | £212.50 ex VAT (Easy Composites) | 255.00 | D-84: one epoxy supplier. Inc VAT calculated. Delivery shown in basket only. Test bricks first (it is a clear casting resin, slow cure) |
| F02 | 1 | Epoxy for leveling pour / grout / samples | 5 kg | Very low viscosity and slow cure (e.g. GlassCast 50 PLUS) | [product](https://www.easycomposites.co.uk/glasscast-50-plus-clear-epoxy-casting-resin) | £76.46 ex VAT per 5 kg kit (Easy Composites) | 91.75 | Same Easy Composites order as F01/F12 |
| F03 | 1 | Coarse aggregate: quartz 2-5 mm | 2 25 kg bags | Washed, kiln-dried angular quartz 2-5 mm (resin-bound grade) | [product](https://www.gclproducts.co.uk/p/resin-bound-gravel/winter-quartz-2-5mm-gravel) | £12.10 ex VAT / £14.52 inc VAT per 25 kg (GCL PermaBound Winter Quartz) | 29.04 | v2 resize: about 32 kg coarse needed. GCL pallet delivery cost to confirm |
| F04 | 1 | Medium + fine: kiln-dried sand 0-1 mm | 3 20 kg bags | Kiln Dried KDIS Pavior Sand 0-1 mm | [product](https://hancockandbrown.com/kiln-dried-block-paving-sand-20kg-bag) | £6.38 inc VAT per 20 kg (Hancock & Brown, Swansea) | 19.14 | D-79 resize: about 43 kg medium + fine. Hancock & Brown £6.38 each |
| F06 | 1 | Filler: whiting (calcium carbonate powder) | 1 25 kg bag | Pottery-grade whiting, dry powder (< 0.1 mm) | [product](https://valentineclays.co.uk/products/whiting) | £20.42 inc VAT per 25 kg (Valentine Clays) | 20.42 | D-64. Delivery cost not shown: check in the basket. Alternatives: Potterycrafts silica flour £36.05 ex VAT (£43.26 inc), Womersleys Trucarb whiting from £11.55 ex VAT (construction chalk, dryness not stated). Keep the bag sealed and dry |
| F07 | 1 | Steel flat bar 40 x 10 mm | 1 3 m bar | 40 × 10 mild steel flat bar, 3 m | [product](https://www.themetalstore.co.uk/products/3-metre-lengths-10mm-flat-bar) | £30.00 ex VAT / £36.00 inc VAT per 3 m bar (The Metal Store) | 36.00 | v2: rail inserts (Y 2 × 400, X 2 × 560) + joint bars, about 3 m |
| F08 | 1 | M12 threaded rod 2 × 1 m + nuts | 1 lot | 5 × Easyfix BZP M12 × 1000 mm rod (5-pack) + 100 × M12 BZP nuts | [product](https://www.screwfix.com/p/easyfix-bzp-steel-threaded-rods-m12-x-1000mm-5-pack/98942) | Rods £19.99 per 5 + nuts £9.09 per 100 inc VAT (Screwfix 98942, 15569), collect Swansea | 29.08 | Nuts: https://www.screwfix.com/p/easyfix-bzp-steel-hex-nuts-m12-100-pack/15569 . Spare rods and nuts |
| F09 | 1 | Steel or PVC tube for M12 bolt sleeves | 2 m | About 14-16 mm bore | [product](https://www.screwfix.com/p/deta-tte-round-upvc-white-conduit-20mm-x-3m/256vt) | £2.29 inc VAT (Screwfix, 20 mm uPVC conduit 3 m) | 2.29 | D-84: back to Screwfix (cheaper than the AliExpress hose, same shopping trip) |
| F10 | 1 | MDF sheets for moulds (floors + walls) | 1 sheet | 18 mm MDF 2440 × 1220: base floor (about 700 × 1,010) + gantry floor (about 700 × 520) in one piece each | [product]() | £28 each (B&Q, owner-confirmed), collect | 28.00 | v2: 3 small moulds fit in one sheet (about 1.5 m²) |
| F11 | 1 | CLS timber 38 x 63 x 2400 (mould bracing) | 6 lengths | Essentials smooth planed C16 whitewood CLS 38 x 63 x 2.4 m | [product](https://www.diy.com/departments/essentials-smooth-planed-c16-whitewood-spruce-cls-timber-l-2-4m-w-63mm-t-38mm/1798294_BQ.prd) | £3.97 each (B&Q, owner-confirmed), collect | 23.82 | v2: smaller moulds. B&Q £3.97 each |
| F12 | 1 | Release agents (Easy Composites) | 1 set | PVA release agent 200 ml + Miracle Gloss release wax 100 g | [product](https://www.easycomposites.co.uk/pva-mould-release-agent) | PVA £3.47 + wax £8.95 ex VAT | 14.90 | Wax: https://www.easycomposites.co.uk/number-8-mould-release-wax . Supplier: do not put PVA over wax |
| F13 | 1 | Plasticine fillets (dropped: use silicone fillets) | 1 set |  | [product]() | Not needed | 0.00 | D-84: silicone (F18) does the corner fillets |
| F14 | 1 | Vibration table (owner DIY: tyres + board + unbalanced motor) | 2 pcs | 1-2 old tyres as springs, stiff board on top, motor with an eccentric weight | [product]() | Owner DIY | 0.00 | D-77 |
| F15 | 1 | Vibration table mounts (replaced by tyres) | 8 pcs | M6 stud, 20 mm dia × 20 mm high rubber feet | [product]() | Not needed | 0.00 | D-77: tyres replace the rubber feet |
| F16 | 1 | Temperature logging (owner DIY) | 1 set | Thermocouples or DS18B20 probes cast in | [product]() | Owner DIY | 0.00 | D-65. DS18B20 probes on a microcontroller |
| F17 | 1 | Mixer | 1 pcs | Paddle mixer or small forced-action mixer | [product](https://www.screwfix.com/p/erbauer-epm1600-1600w-electric-paddle-mixer-220-240v/981kj) | £69.99 inc VAT (Screwfix) | 69.99 | Erbauer EPM1600 |
| F18 | 1 | Silicone (Screwfix) + packing tape (AliExpress) | 1 set | 2 × No Nonsense 291 neutral-cure silicone 310 ml; 2 × 48 mm × 110 m tape | [product](https://www.screwfix.com/p/no-nonsense-291-builders-silicone-clear-310ml/83710) | Silicone £5.49 each (Screwfix 83710) + tape £6.71 (AliExpress) | 17.69 | Tape: https://www.aliexpress.com/item/1005006967362821.html |
| M01 | 1 | HGR20 rail kit Y: 2 × 500 mm + 4 blocks | 2 pcs | Y: 2 × 500 mm HGR20 + 4 × HGH20CA (min 478, D-80) | [product](https://www.aliexpress.com/item/1005010242098397.html) | £64.79 inc VAT, free shipping (AliExpress, logged in; no per-shopper limit) | 64.79 | Y 2 × 400 mm. Deal price per size: if refused, normal £126.79. Kaiyade fallback £21.29 + £79.28 shipping PER ITEM (not per order) |
| M02 | 1 | HGR20 rail kit X: 2 × 800 mm + 4 blocks | 2 pcs | X: 2 × 800 mm HGR20 + 4 × HGH20CA (min 748, D-79) | [product](https://www.aliexpress.com/item/1005010242098397.html) | £81.99 inc VAT, free shipping (AliExpress, logged in) | 81.99 | Deal price: if refused, normal £163.88. Kaiyade alt £28.29 + £79.28 shipping |
| M03 | 1 | HGR20 rail kit Z: 2 × 350 mm + 4 blocks | 2 pcs | Z: 2 × 350 mm HGR20 + 4 × HGH20CA (v2, min 318) | [product](https://www.aliexpress.com/item/1005010242098397.html) | £60.59 inc VAT, free shipping (AliExpress, logged in) | 60.59 | Switched from Kaiyade: its shipping is per item, not per order (task 6). Deal price: if refused, normal £120.47 |
| M04 | 1 | HGH20CA carriages (in the rail kits) | 12 pcs | 4 per axis | [product]() | Included in M01-M03 | 0 | 4 HGH20CA per Kaiyade kit. Preload not stated |
| M05 | 1 | DFU1605 ballscrew kits X 750 / Y 450 / Z 350 | 3 pcs | DFU1605 kits: X 750, Y 450, Z 350 mm (mins 725 / 405 / 305, D-79) | [product](https://www.aliexpress.com/item/1005010046279521.html) | £77.19 + £59.19 + £54.79 inc VAT + 3 × £7.88 (AliExpress, logged in) | 214.81 | D-79. "Guide Length" not defined (overall vs thread): ask the seller. Shipping shown for 1 kit, may be per kit. X normal £87.72 |
| M06 | 1 | BK12 + BF12 end supports (in the screw kits) | 3 sets |  | [product](https://www.aliexpress.com/item/1005010046279521.html) | Included in M05 | 0 |  |
| M07 | 1 | Nut housings (in the screw kits) | 3 pcs |  | [product](https://www.aliexpress.com/item/1005010046279521.html) | Included in M05 | 0 |  |
| M08 | 1 | Disc or bellows coupling 10 mm to 10 mm | 3 pcs | Listings give a 10 mm shaft on the 4 Nm NEMA 24 (24HS40-5004D-E1000). Verify. BK12 end is 10 mm | [product](https://www.aliexpress.com/item/1005009879991986.html) | 3 × £3.35 + £4.05 (AliExpress, logged in) | 14.10 | D26 L35 double diaphragm, 10 × 10 bore. All 3 motors confirmed 10 mm shaft |
| M09 | 1 | NEMA 24 closed-loop stepper + driver about 4 Nm | 2 sets | X and Y. Candidate: StepperOnline 1-CL57T-S40-V41 (24HS40-5004D-E1000 + CL57T V4.1 / 24-48 V DC / 1000 PPR encoder) | [product](https://www.omc-stepperonline.com/ts-series-4-0-nm-566-56oz-in-1-axis-closed-loop-stepper-cnc-kit-nema-24-motor-driver-1-cl57t-s40-v41) | £51.34 (VAT?) per set + £10.03 UK warehouse (StepperOnline) | 112.71 | 24HS40-5004D-E1000 + CL57T-V41. Shaft 10 mm D-cut. UK stock 5. VAT basis unclear |
| M10 | 1 | NEMA 24 closed-loop stepper with 24 V brake | 1 set | StepperOnline 24HS34-5004D-E1000-B280: 3 Nm / 5 A / 1000 PPR encoder / 2.8 Nm 24 V power-off brake | [product](https://www.omc-stepperonline.com/s-series-nema-24-closed-loop-stepper-motor-3-0nm-424-92oz-in-with-2-8nm-396-51oz-in-electromagnetic-brake-24hs34-5004d-e1000-b280) | £59.22 (VAT?) (StepperOnline) | 59.22 | China warehouse only, backorder, est. 13-19 Nov. Shaft 10 mm D-cut. Shipping not shown |
| M14 | 1 | CL57T V4.1 closed-loop driver | 1 pcs | For the Z brake motor. 24-48 V DC / 0-8 A | [product](https://www.omc-stepperonline.com/closed-loop-stepper-driver-v4-1-0-8-0a-24-48vdc-for-nema-17-23-24-stepper-motor-cl57t-v41) | £28.75 (VAT?) + £5.47 DE warehouse (StepperOnline) | 34.22 | No UK stock |
| M11 | 1 | Table plate 6082 460 × 330 × 25 | 1 pcs | 6082 aluminium 460 × 330 × 25 mm (D-79) | [product](https://www.aluminiumwarehouse.co.uk/products/25-mm-6082-aluminium-plate) | £184.44 ex VAT, 6082 460 × 330 × 25 custom cut (Aluminium Warehouse) | 221.33 | D-79. Inc VAT calculated. Order with M12 + A06 (free delivery over £150 ex VAT unless SA2 is excluded). Cast tooling plate £251.04 ex VAT |
| M12 | 1 | Saddle + Z plates 6082 20 mm | 1 lot | 6082 20 mm: saddle about 180 × 160, Z plate about 140 × 320 (v2) | [product](https://www.aluminiumwarehouse.co.uk/products/20-mm-6082-aluminium-plate) | £27.99 (180 × 160 × 20) + £43.55 (320 × 140 × 20) ex VAT (Aluminium Warehouse) | 85.85 | Same order as M11. Inc VAT calculated |
| M13 | 1 | Motor and bearing mounts | 1 lot | Machined or bought brackets | [product](https://www.aliexpress.com/item/1005006232398099.html) | 3 × £9.99 + £25.19 shipping (AliExpress, logged in) | 55.16 | Earlier price counted shipping for one bracket only |
| S01 | 2 | Jianken JGL-80/2.2R24-20 ATC spindle | 1 pcs | 2.2 kW / 24000 rpm / 400 Hz / 220 V / about 0.87 Nm / ISO20 / water-cooled / 80 mm body. Order the clamp/unclamp sensor variant (PNP) | [product](https://www.alibaba.com/product-detail/Jianken-JGL-80-2-2KW-24000RPM_1601249825246.html) | £937.79 (VAT?) + £52.78 shipping (Alibaba, 1-4 pcs) | 990.57 | Owner is contacting Jianken and ordering. Drawing confirms JGL-80/2.2R24, 220 V, 400 Hz, ISO20-ER16, water-cooled. Sensors: clamped/released + temperature, PNP 24 V. VFD not included. Pull stud not shown. KEY ATTRIBUTES SAY 0.7 Nm (other listings 0.87 Nm): confirm with Jianken. Import VAT likely on top. Delivery 18 Nov-19 Dec. Alt AliExpress with 2.2 kW VFD £1402.79 inc VAT + £140.15: https://www.aliexpress.com/item/1005010706946690.html |
| S08 | 1 | G-Penny 2.2 kW ER20 water-cooled spindle kit | 1 pcs | BST2.2C-80-24K: 2.2 kW, 220 V, 400 Hz, 24,000 rpm, 0.88 Nm, ER20, Ø80 × 230 (+52 nose), 5.5 kg, runout 0.005 mm, bearings 2 × 7005C + 2 × 7002C P4 DT. Kit: Huanyang 2.2 kW VFD (220 V 1-ph in, 0-400 Hz), 80 mm clamp, 75 W 220 V pump + 5 m hose, ER20 collets 4/6/8/10/12 mm + 1/8, 1/4, 1/2 in | [product](https://www.aliexpress.com/item/32253760001.html) | £217.39 + £100.77 shipping (owner, AliExpress), delivery 8 Jan | 318.16 | D-78. Known maker with stated runout and P4 bearings. Shipping is heavy (about 9 kg kit): a UK/EU-stock seller may be cheaper or faster |
| S09 | 1 | ER20 collet set | 1 set | 13 × ER20 collets 1-13 mm, AA 0.008 mm, boxed + ER20A spanner | [product](https://www.aliexpress.com/item/1005010595086817.html) | Collets £27.79 + spanner £3.25 (AliExpress, logged in) | 31.04 | Small sizes (1-3 mm) not in the kit collets: keep for small tools. Spanner may come with the kit: check |
| S02 | 1 | VFD (included in the G-Penny kit, S08) | 1 pcs | 2.2 kW, 1-phase 220 V in, 3-phase 220 V out, 0-600 Hz, RS-485 Modbus-RTU stated | [product](https://www.aliexpress.com/item/32253760001.html) | Included in S08 | 0.00 | D-78. Huanyang HY: Modbus over RS-485 via LinuxCNC hy_vfd / Mesa RS-485 (D-32, D-58). Previous ZEST VFD £88.94 no longer needed |
| S03 | 1 | 80 mm spindle clamp (included in S08) | 1 pcs | 80 mm | [product](https://www.aliexpress.com/item/32253760001.html) | Included in S08 | 0.00 | D-78 |
| S04 | 1 | Screened 4-core cable 16 AWG, 4 × 5 m (spindle + 3 motors) | 4 × 5 m |  | [product](https://www.aliexpress.com/item/32971008305.html) | £19.03 each inc VAT, free shipping (AliExpress) | 76.12 | D-84: premium accepted. Covers E20. 16 AWG ≈ 1.3 mm² |
| S05 | 1 | Spindle cooling loop (DIY) | 1 pcs | Kit 220 V pump (S08) in a sealed reservoir; 240 mm radiator G1/4; 2 × 120 mm 12 V fans (in series on 24 V); 2 × 8 mm × 1/4 barbs; 60 hose clamps; brass flow switch G1/4 NO 1.5-3 L/min; 5 m 8 mm ID braided PVC hose | [product](https://www.aliexpress.com/item/1005007038307491.html) | Radiator £13.35 + basket fans £8.70, barbs £2.38, clamps £17.89 + flow switch £12.51 (AliExpress) + 8 mm ID hose £8.99 (B&Q marketplace, free delivery) | 63.82 | D-85. Flow switch: https://www.aliexpress.com/item/1005010428362103.html (contact rating not stated: check before wiring to a 7i76EU input). Hose: https://www.diy.com/departments/clear-pvc-braided-hose-food-grade-oil-water-fuel-reinforced-pipe-tube-8mm-internal-12mm-external-5m-/5060449706401_BQ.prd . Remove the 6 mm ID tube from the AliExpress basket |
| S06 | 2 | ISO20 ER16 holders with pull studs | 8 pcs | ISO20-ER16. Pull studs must match the spindle drawbar | [product](https://www.aliexpress.com/item/4000141590118.html) | £6.05 inc VAT each, free shipping (AliExpress; list £22.37) | 48.40 | ISO20-ER16-35L, 0.003 mm. £6.05 may be a new-shopper deal: at list price 8 × £22.37 = £178.96. PULL STUD NOT STATED: must match Jianken. Jianken own holders £37.52-75.03 on the S01 page. DamenCNC Teknomotor €123.50 each |
| S07 | 2 | ER16 collet set | 1 set | Precision (AA grade or better) 1-10 mm | [product](https://www.aliexpress.com/item/1005005626185405.html) | £17.89 inc VAT, free shipping (AliExpress) | 17.89 | AA ER16 10-piece set. Sizes not listed. AAA set £68.39 |
| A01 | 2 | ISO20 tool forks (3D printed) | 8 pcs | 3D-printed ISO20 forks from a friend's model | [product]() | Owner sourcing (3D printed) | 0.00 | D-58. Print in PETG/ASA/PA for stiffness and heat. Check grip force and holder fit before Stage 2 |
| A03 | 2 | Small closed-loop stepper + driver (48 V) | 1 set | Drives the rack slide | [product](https://www.omc-stepperonline.com/1-axis-closed-loop-stepper-cnc-kit-80ncm-113-29oz-in-nema-17-motor-driver-1-cl42t-s08-v41) | £39.43 (VAT?) + £8.34 DE warehouse (StepperOnline) | 47.77 | 1-CL42T-S08-V41: NEMA 17 0.8 Nm + CL42T 24-48 V. 5 mm shaft |
| A05 | 2 | Tool length setter (wired switch) | 1 pcs | On the rack carrier | [product](https://www.aliexpress.com/item/1005012101891449.html) | £17.89 inc VAT, free shipping (AliExpress) | 17.89 | N96R, 24 V, NC |
| A06 | 2 | ATC wheel discs + bracket | 1 lot | Aluminium: 2 × Ø200 × 8 discs + leg bracket (v2 ferris wheel) | [product](https://www.aluminiumwarehouse.co.uk/products/8-mm-6082-aluminium-plate) | 2 × 200 × 200 × 8 (£15.55 each) + 150 × 120 × 10 (£15.00) ex VAT (Aluminium Warehouse) | 55.32 | Squares: cut the discs yourself. Add to the M11/M12 order. Inc VAT calculated |
| A07 | 2 | ATC wheel shaft + 2 bearings | 1 set | Ø20 × 150 chrome steel shaft + 2 × KFL004 20 mm flange bearings | [product](https://www.aliexpress.com/item/1005007995333691.html) | Shaft £11.99 + £2.25 shipping; bearings £7.50 for 2 (AliExpress, logged in) | 21.74 | Bearings: https://www.aliexpress.com/item/1005007098430647.html (under £8: shipping fee only shown in basket). Turn the shaft end to 18 mm for the 60T pulley (A08) |
| A08 | 2 | ATC wheel drive reduction | 1 set | GT2 belt + pulleys about 3:1 (or a small worm gearbox) for the NEMA 17 | [product](https://www.aliexpress.com/item/32650791423.html) | 20T £0.99 + 60T £3.99 + £3.35 shipping + belt 222 mm £0.99 (AliExpress) | 9.32 | 60T has an 18 mm bore with keyway: turn the shaft end to 18 mm. 20T and belt are 1-per-shopper deals (normal £4.72, £2.74). 222 mm belt gives about 70 mm centres |
| A09 | 2 | ATC wheel index sensor | 1 set | Inductive sensor M8/M12 PNP + home flag | [product](https://www.aliexpress.com/item/1005010648075147.html) | Added to E10 order: £1.54 + £0.88 extra shipping | 2.42 | Bought with E10 (5 sensors) |
| P01 | 2 | Filter / regulator / dryer | 1 pcs |  | [product](https://www.aliexpress.com/item/1005002589702135.html) | £6.50 inc VAT (AliExpress) | 6.50 | AW2000-02 filter-regulator. No dryer |
| P02 | 2 | 24 V solenoid valves | 4 pcs | Tool release / taper clean / air blast | [product](https://www.aliexpress.com/item/1005012294513653.html) | £9.49 inc VAT each, free shipping (AliExpress) | 37.96 | 3V1-06 24 V 3/2 NC. Qty 4 (3 + 1 for mist unit) |
| P03 | 2 | Air pressure switch | 1 pcs | About 5.5 bar trip point | [product](https://www.aliexpress.com/item/1005013285557375.html) | £5.17 (VAT?) + £3.79 shipping (AliExpress) | 8.96 | QPM11-NO-02. NO contact |
| P04 | 2 | Mist coolant system with 24 V solenoid | 1 set |  | [product](https://www.aliexpress.com/item/1005012241646016.html) | £17.59 inc VAT (AliExpress) | 17.59 | BPV-3000 mist unit, no solenoid (uses 4th P02 valve) |
| P05 | 2 | Push-fit tubing and fittings 6/8 mm | 1 lot |  | [product](https://www.aliexpress.com/item/1005006780298909.html) | £4.31 + £7.56 inc VAT (AliExpress) | 11.87 | 10 m 6 × 4 + 10 m 8 × 5 PU. Fittings NOT priced |
| P06 | 2 | Push-in fittings | 12 pcs | 10 × RS PRO 6 mm × R1/8 push-in (2 packs) + 5 × John Guest PM010812E 8 mm × G1/4 | [product](https://uk.rs-online.com/web/p/pneumatic-fittings/2993932) | £8.03 inc per 5 (6 mm) × 2 + £11.28 inc per 5 (8 mm) (RS) | 27.34 | 8 mm: https://uk.rs-online.com/web/p/pneumatic-fittings/7042758 . Add to the RS order (free delivery over £60) |
| E01 | 1 | Mesa 7i76EU | 1 pcs |  | [product](https://store.mesanet.com/index.php?route=product/product&product_id=399) | €309.31 = £257.74 incl. import VAT (owner-confirmed price, not yet bought) | 257.74 | Price includes import VAT. Order in wave 1 (week 1) |
| E02 | 1 | Mini-PC (owner already has) | 1 pcs |  | [product]() | Owner sourced | 0.00 | D-58. Onboard Intel NIC goes to the Mesa board. No 2nd NIC: machine stays offline |
| E03 | 1 | Monitor + keyboard + mouse (owner already has) | 1 set |  | [product]() | Owner sourced | 0.00 | D-58 |
| E04 | 1 | 48 V PSU Mean Well SDR-480-48 (DIN) | 1 pcs | Mean Well SDR-480-48, 48 V 10 A 480 W, DIN rail | [product](https://uk.rs-online.com/web/p/switching-power-supplies/0424868) | £113.38 ex / £136.06 inc VAT (RS 042-4868) | 136.06 | D-84. RS free delivery over £60 |
| E05 | 1 | 24 V DC PSU, DIN rail (Mean Well HDR-150-24) | 1 pcs | Mean Well HDR-150-24, DIN rail | [product](https://www.omc-stepperonline.com/hdr-150-24-mean-well-24vdc-5-31a-127-4w-115vac-6-25a-150w-230vac-ultra-slim-step-shape-din-rail-power-supply-hdr-150-24) | £27.62 (VAT?), pre-order (StepperOnline, read 2026-11-05) | 27.62 | D-84: kept at StepperOnline (already a vendor, genuine). Was pre-order: check stock |
| E22 | 2 | 5 V DC PSU (shelved: not needed for Phase 1) | 1 pcs | Mean Well MDR-10-5, 5 V 2 A, DIN rail | [product](https://uk.rs-online.com/web/p/din-rail-power-supplies/7127402) | £13.04 ex / £15.65 inc VAT (RS 712-7402) | 15.65 | D-91: the 7I76EU runs from 24 V. Kept for later use (owner) |
| E23 | 1 | Coolant pump relay (DIN interface relay, 24 V DC coil) | 1 pcs | DIN-rail interface relay, 24 V DC coil, 1 CO, about 10 A 250 V AC contact, with LED (e.g. Finder 38/39 series) | [product](https://uk.rs-online.com/) | TO PRICE (RS) |  | Switches the 220 V kit pump from Mesa OUT2 |
| E06 | 1 | E-stop safety relay Schneider Preventa XPSAC5121 | 1 pcs | 24 V AC/DC, e-stop monitoring, 1 or 2 channel, manual reset | [product](https://www.aliexpress.com/item/1005012583131933.html) | £84.39 inc VAT, free shipping (AliExpress, 107 sold) | 84.39 | D-84: premium accepted (no eBay). Genuine part not verified. Wire each e-stop's 2 NC contacts as two channels; reset button to the reset input; safety outputs to the E07 coil |
| E07 | 1 | Contactor with 24 V coil | 1 pcs |  | [product](https://www.aliexpress.com/item/1005005356561757.html) | £26.29 inc VAT, free shipping (AliExpress, logged in) | 26.29 | Schneider LC1D09BDC 24 V DC coil. Genuine not verified |
| E08 | 1 | E-stop buttons 2 NC (×5) | 1 set | XB2-BS544 22 mm, 2 NC, twist release (2 NC for the dual-channel relay) | [product](https://www.aliexpress.com/item/1005008293871583.html) | £12.39 inc VAT for 5, free shipping (AliExpress, option BS544-2NC) | 12.39 | D-84: 2 NC needed for dual-channel E06 |
| E09 | 1 | MCBs / main isolator / EMC filter for VFD | 1 set |  | [product](https://www.aliexpress.com/item/1005010519550019.html) | £10.39 inc VAT, free shipping (AliExpress) | 10.39 | CW4L2-20A-S. MCBs and isolator NOT priced |
| E10 | 1 | Inductive proximity switches 24 V | 5 pcs | LJ12A3-4-Z/BY M12 PNP NO 4 mm (4 homing + 1 for the ATC wheel index, A09) | [product](https://www.aliexpress.com/item/1005010648075147.html) | £1.54 each + £6.92 shipping for 5 (AliExpress, logged in) | 12.20 | Includes the A09 sensor (its extra £2.42 is counted on A09, Phase 3) |
| E12 | 1 | Electrical cabinet RS PRO 600 × 400 × 200 IP66 | 1 set | RS PRO steel wall box IP66 600 × 400 × 200, chassis plate, gland plate | [product](https://uk.rs-online.com/web/p/wall-boxes/7755817) | £90.87 ex / £109.04 inc VAT (RS 775-5817) | 109.04 | Owner decision 8 Nov: keep 600 × 400 (premium accepted) |
| E13 | 1 | DIN rail, terminals, end stops, ferrules + crimper, wire | 1 lot | 2 × 500 mm DIN rail, HSC8 6-4 crimper + 300 ferrules, BVR 1.5 mm² 10 m (mains), UL1007 18 AWG 10 m (24 V only); RS 30 × 2.5 mm² terminals + 5 end stops | [product](https://www.aliexpress.com/item/4000151397971.html) | AliExpress: rail 2 × £5.51, crimper kit £7.83, 1.5 mm² £16.69, 18 AWG £3.65. RS: terminals £10.56, end stops £2.51 | 52.26 | Crimper kit https://www.aliexpress.com/item/1005012223962740.html ; 1.5 mm² https://www.aliexpress.com/item/1005011853538687.html ; 18 AWG https://www.aliexpress.com/item/1005011594190524.html ; RS terminals https://uk.rs-online.com/web/p/din-rail-terminal-blocks/8787503 . Covers E19 |
| E14 | 1 | Cable chain and shielded motor cables | 1 lot |  | [product](https://www.aliexpress.com/item/1005012723966521.html) | £15.79 inc VAT, free shipping (AliExpress) | 15.79 | 1 m only: length TBD. Shielded motor cable NOT priced |
| E15 | 2 | Enclosure door switch | 1 pcs |  | [product](https://www.aliexpress.com/item/1005006072968001.html) | £8.07 inc VAT (AliExpress) | 8.07 | CZ-93B key interlock, 2 NC. No safety standard stated |
| E17 | 1 | Isolator + MCBs | 1 set | EARU 2P 40 A isolator + CHINT NXB-63 1P C16 + 2 × C6 | [product](https://www.aliexpress.com/item/1005006908131326.html) | Isolator £4.43 + C16 £3.82 + 2 × C6 £3.95 inc VAT (AliExpress) | 16.15 | MCBs: https://www.aliexpress.com/item/1005002971655457.html (order ≥ £8: free shipping). Isolator alone under £8: fee not shown |
| E18 | 1 | Cabinet filter fan + exhaust grille (9803 series) | 1 set | 9803-230 120 mm 230 V filter fan + 9803-300 exhaust grille | [product](https://www.aliexpress.com/item/1005003027013500.html) | Fan £7.41 + £9.93 shipping, grille £4.99 (AliExpress) | 22.33 | Grille: https://www.aliexpress.com/item/32884649030.html . Same series, cutouts match |
| E19 | 1 | (covered by E13) | 1 set | 1 m DIN, ferrule kit + crimper, 0.75 and 1.5 mm² wire 10 m each | [product]() | Included in E13 | 0.00 |  |
| E20 | 1 | (covered by S04) | 15 m | CY 4-core 1.0 mm² | [product]() | Included in S04 | 0.00 |  |
| E21 | 1 | Reset button 22 mm green (in your basket) | 1 pcs | 22 mm green, 2 NO, momentary, 24 V LED | [product](https://www.aliexpress.com/item/1005006872683640.html) | £4.25 inc VAT (AliExpress basket, Sweideer) | 4.25 | Already in your AliExpress basket |
| N01 | 2 | Enclosure box: 12 mm MDF (B&Q) | 2 sheets | 12 mm MDF, 2 sheets: box internal 880 × 930 × 742 (cut list: cad/v2/out/enclosure_cutlist.md) | [product](https://www.diy.com/departments/mdf-board-l-2-44m-w-1-22m-t-12mm-22130g/1696260_BQ.prd) | £23 each inc VAT (B&Q, sold and shipped by B&Q) | 46.00 | D-89: moved from Wickes (£26 each). 2 sheets (cut list: cad/v2/out/enclosure_cutlist.md). Check Swansea stock for click and collect. Seal the inside |
| N02 | 2 | Enclosure window: 4 mm solid clear polycarbonate | 1 pcs | Solid clear polycarbonate 4 mm, cut to 600 × 420 (covers the 560 × 380 door cut-out with 20 mm overlap) | [product](https://www.plasticsheets.com/clear-polycarbonate/) | £24.92 + £4.95 delivery (plasticsheets.com, owner-confirmed; VAT basis not stated) | 29.87 | D-88: replaces the ribbed twinwall (£23.99) for a clear view. 3 mm option was £18.55 + £4.95 |
| N03 | 2 | LED light | 1 pcs |  | [product](https://www.aliexpress.com/item/1005013221981188.html) | £2.74 inc VAT (AliExpress) | 2.74 | 24-36 V 5 W |
| T01 | 1 | Bench (owner-built timber) | 1 lot | Owner-built timber bench, top 785 mm above the floor, carries about 150 kg + enclosure | [product]() | Owner build | 0.00 | D-71 |
| T02 | 1 | Anti-vibration feet | 4 pcs | 4 × RS PRO levelling foot M10 × 45, 50 mm polyamide base, 470 kg | [product](https://uk.rs-online.com/web/p/adjustable-feet/0285757) | £10.16 ex / £12.19 inc VAT (RS 028-5757) | 12.19 | Polyamide base, not rubber: add rubber pads if needed for vibration |
| X01 | 1 | Dial test indicator + magnetic base | 1 set | For rail alignment and squaring the gantry | [product](https://www.aliexpress.com/item/1005013036061506.html) | £17.23 inc VAT, free shipping (AliExpress) | 17.23 | Lever DTI 0.01 mm + flexible base |
| X02 | 1 | Precision level 200 mm (AliExpress) | 1 pcs | 200 mm bar level, title "0.02 mm" (per-metre not stated) | [product](https://www.aliexpress.com/item/32814850915.html) | £15.69 + £17.25 shipping (AliExpress) | 32.94 | D-84: owner choice. Sensitivity unit not confirmed |
| X03 | 1 | Socket cap screws (M5/M6/M8/M10/M12) | 1 lot | M5 × 16 (100) + M6 × 20 (50) A2 [Screwfix]; M10 × 30 12.9 (20) [AliExpress]; M8 × 25 (50) + M12 × 120 (10) [RS] | [product](https://www.screwfix.com/) | Screwfix 2 × £5.79 + £7.59; AliExpress 10 × £1.52; RS £11.96 + £24.14 | 70.47 | Screwfix 4366T, 5209T; AliExpress https://www.aliexpress.com/item/4000784829771.html ; RS 052-9725, 124-7302. Covers X04 |
| X04 | 1 | (covered by X03) | 1 set | 100 × M5 × 16 + 10 × M12 × 120, grade 12.9 | [product]() | Included in X03 | 0.00 |  |
