yousef-chitani/Type_0_CNC/docs/phase1-bom.xlsx

Sheet: Phase 1
Type 0 CNC v2: Phase 1 parts list (work area 400 × 250)
Blue = price read from a live page or given by the owner. Yellow columns are for you: Bought? (Y/N) and Actual paid £ (e.g. Y and 61.20). Links: click to open.
ID | Subsystem | Item | Qty | Unit | Specification | Price as listed | Line £ | Link | Link 2 | Link 3 | Notes | Date checked | Bought? (Y/N) | Actual paid £
F01 | Frame | Main EG epoxy: GlassCast 50 PLUS 15 kg | 1 | kit | GlassCast 50 PLUS 15 kg: about 300 mPa·s mixed, pot life about 2 h at 20 °C, 69:31 by weight, slow cure (7 days) | £212.50 ex VAT (Easy Composites) | £255.00 | Easy Composites (https://www.easycomposites.co.uk/glasscast-50-plus-clear-epoxy-casting-resin) |  |  | D-84: one epoxy supplier. Inc VAT calculated. Delivery shown in basket only. Test bricks first (it is a clear casting resin, slow cure) | 2026-11-08
F02 | Frame | Epoxy for leveling pour / grout / samples | 5 | kg | Very low viscosity and slow cure (e.g. GlassCast 50 PLUS) | £76.46 ex VAT per 5 kg kit (Easy Composites) | £91.75 | Easy Composites (https://www.easycomposites.co.uk/glasscast-50-plus-clear-epoxy-casting-resin) |  |  | Same Easy Composites order as F01/F12 | 2026-11-08
F03 | Frame | Coarse aggregate: quartz 2-5 mm | 2 | 25 kg bags | Washed, kiln-dried angular quartz 2-5 mm (resin-bound grade) | £12.10 ex VAT / £14.52 inc VAT per 25 kg (GCL PermaBound Winter Quartz) | £29.04 | GCL (https://www.gclproducts.co.uk/p/resin-bound-gravel/winter-quartz-2-5mm-gravel) |  |  | v2 resize: about 32 kg coarse needed. GCL pallet delivery cost to confirm | 2026-11-06
F04 | Frame | Medium + fine: kiln-dried sand 0-1 mm | 3 | 20 kg bags | Kiln Dried KDIS Pavior Sand 0-1 mm | £6.38 inc VAT per 20 kg (Hancock & Brown, Swansea) | £19.14 | Hancock & Brown (https://hancockandbrown.com/kiln-dried-block-paving-sand-20kg-bag) |  |  | D-79 resize: about 43 kg medium + fine. Hancock & Brown £6.38 each | 2026-11-07
F06 | Frame | Filler: whiting (calcium carbonate powder) | 1 | 25 kg bag | Pottery-grade whiting, dry powder (< 0.1 mm) | £20.42 inc VAT per 25 kg (Valentine Clays) | £20.42 | Valentine Clays (https://valentineclays.co.uk/products/whiting) |  |  | D-64. Delivery cost not shown: check in the basket. Alternatives: Potterycrafts silica flour £36.05 ex VAT (£43.26 inc), Womersleys Trucarb whiting from £11.55 ex VAT (construction chalk, dryness not stated). Keep the bag sealed and dry | 2026-11-05
F07 | Frame | Steel flat bar 40 x 10 mm | 1 | 3 m bar | 40 × 10 mild steel flat bar, 3 m | £30.00 ex VAT / £36.00 inc VAT per 3 m bar (The Metal Store) | £36.00 | The Metal Store (https://www.themetalstore.co.uk/products/3-metre-lengths-10mm-flat-bar) |  |  | v2: rail inserts (Y 2 × 400, X 2 × 560) + joint bars, about 3 m | 2026-11-06
F08 | Frame | M12 threaded rod 2 × 1 m + nuts | 1 | lot | 5 × Easyfix BZP M12 × 1000 mm rod (5-pack) + 100 × M12 BZP nuts | Rods £19.99 per 5 + nuts £9.09 per 100 inc VAT (Screwfix 98942, 15569), collect Swansea | £29.08 | Screwfix (https://www.screwfix.com/p/easyfix-bzp-steel-threaded-rods-m12-x-1000mm-5-pack/98942) | Screwfix (https://www.screwfix.com/p/easyfix-bzp-steel-hex-nuts-m12-100-pack/15569) |  | Nuts: . Spare rods and nuts | 2026-11-08
F09 | Frame | Steel or PVC tube for M12 bolt sleeves | 2 | m | About 14-16 mm bore | £2.29 inc VAT (Screwfix, 20 mm uPVC conduit 3 m) | £2.29 | Screwfix (https://www.screwfix.com/p/deta-tte-round-upvc-white-conduit-20mm-x-3m/256vt) |  |  | D-84: back to Screwfix (cheaper than the AliExpress hose, same shopping trip) | 2026-11-08
F10 | Frame | MDF sheets for moulds (floors + walls) | 1 | sheet | 18 mm MDF 2440 × 1220: base floor (about 700 × 1,010) + gantry floor (about 700 × 520) in one piece each | £28 each (B&Q, owner-confirmed), collect | £28.00 | owner / DIY / included |  |  | v2: 3 small moulds fit in one sheet (about 1.5 m²) | 2026-11-06
F11 | Frame | CLS timber 38 x 63 x 2400 (mould bracing) | 6 | lengths | Essentials smooth planed C16 whitewood CLS 38 x 63 x 2.4 m | £3.97 each (B&Q, owner-confirmed), collect | £23.82 | B&Q (https://www.diy.com/departments/essentials-smooth-planed-c16-whitewood-spruce-cls-timber-l-2-4m-w-63mm-t-38mm/1798294_BQ.prd) |  |  | v2: smaller moulds. B&Q £3.97 each | 2026-11-06
F12 | Frame | Release agents (Easy Composites) | 1 | set | PVA release agent 200 ml + Miracle Gloss release wax 100 g | PVA £3.47 + wax £8.95 ex VAT | £14.90 | Easy Composites (https://www.easycomposites.co.uk/pva-mould-release-agent) | Easy Composites (https://www.easycomposites.co.uk/number-8-mould-release-wax) |  | Wax: . Supplier: do not put PVA over wax | 2026-11-08
F13 | Frame | Plasticine fillets (dropped: use silicone fillets) | 1 | set |  | Not needed | £0.00 | owner / DIY / included |  |  | D-84: silicone (F18) does the corner fillets | 2026-11-08
F14 | Frame | Vibration table (owner DIY: tyres + board + unbalanced motor) | 2 | pcs | 1-2 old tyres as springs, stiff board on top, motor with an eccentric weight | Owner DIY | £0.00 | owner / DIY / included |  |  | D-77 | 2026-11-05
F15 | Frame | Vibration table mounts (replaced by tyres) | 8 | pcs | M6 stud, 20 mm dia × 20 mm high rubber feet | Not needed | £0.00 | owner / DIY / included |  |  | D-77: tyres replace the rubber feet | 2026-11-05
F16 | Frame | Temperature logging (owner DIY) | 1 | set | Thermocouples or DS18B20 probes cast in | Owner DIY | £0.00 | owner / DIY / included |  |  | D-65. DS18B20 probes on a microcontroller | 2026-11-05
F17 | Frame | Mixer | 1 | pcs | Paddle mixer or small forced-action mixer | £69.99 inc VAT (Screwfix) | £69.99 | Screwfix (https://www.screwfix.com/p/erbauer-epm1600-1600w-electric-paddle-mixer-220-240v/981kj) |  |  | Erbauer EPM1600 | 2026-11-05
F18 | Frame | Silicone (Screwfix) + packing tape (AliExpress) | 1 | set | 2 × No Nonsense 291 neutral-cure silicone 310 ml; 2 × 48 mm × 110 m tape | Silicone £5.49 each (Screwfix 83710) + tape £6.71 (AliExpress) | £17.69 | Screwfix (https://www.screwfix.com/p/no-nonsense-291-builders-silicone-clear-310ml/83710) | AliExpress (https://www.aliexpress.com/item/1005006967362821.html) |  | Tape | 2026-11-08
M01 | Motion | HGR20 rail kit Y: 2 × 500 mm + 4 blocks | 2 | pcs | Y: 2 × 500 mm HGR20 + 4 × HGH20CA (min 478, D-80) | £64.79 inc VAT, free shipping (AliExpress, logged in; no per-shopper limit) | £64.79 | AliExpress (https://www.aliexpress.com/item/1005010242098397.html) |  |  | Y 2 × 400 mm. Deal price per size: if refused, normal £126.79. Kaiyade fallback £21.29 + £79.28 shipping PER ITEM (not per order) | 2026-11-08
M02 | Motion | HGR20 rail kit X: 2 × 800 mm + 4 blocks | 2 | pcs | X: 2 × 800 mm HGR20 + 4 × HGH20CA (min 748, D-79) | £81.99 inc VAT, free shipping (AliExpress, logged in) | £81.99 | AliExpress (https://www.aliexpress.com/item/1005010242098397.html) |  |  | Deal price: if refused, normal £163.88. Kaiyade alt £28.29 + £79.28 shipping | 2026-11-08
M03 | Motion | HGR20 rail kit Z: 2 × 350 mm + 4 blocks | 2 | pcs | Z: 2 × 350 mm HGR20 + 4 × HGH20CA (v2, min 318) | £60.59 inc VAT, free shipping (AliExpress, logged in) | £60.59 | AliExpress (https://www.aliexpress.com/item/1005010242098397.html) |  |  | Switched from Kaiyade: its shipping is per item, not per order (task 6). Deal price: if refused, normal £120.47 | 2026-11-08
M04 | Motion | HGH20CA carriages (in the rail kits) | 12 | pcs | 4 per axis | Included in M01-M03 | £0.00 | owner / DIY / included |  |  | 4 HGH20CA per Kaiyade kit. Preload not stated | 2026-11-05
M05 | Motion | DFU1605 ballscrew kits X 750 / Y 450 / Z 350 | 3 | pcs | DFU1605 kits: X 750, Y 450, Z 350 mm (mins 725 / 405 / 305, D-79) | £77.19 + £59.19 + £54.79 inc VAT + 3 × £7.88 (AliExpress, logged in) | £214.81 | AliExpress (https://www.aliexpress.com/item/1005010046279521.html) |  |  | D-79. "Guide Length" not defined (overall vs thread): ask the seller. Shipping shown for 1 kit, may be per kit. X normal £87.72 | 2026-11-08
M06 | Motion | BK12 + BF12 end supports (in the screw kits) | 3 | sets |  | Included in M05 | £0.00 | AliExpress (https://www.aliexpress.com/item/1005010046279521.html) |  |  |  | 2026-11-05
M07 | Motion | Nut housings (in the screw kits) | 3 | pcs |  | Included in M05 | £0.00 | AliExpress (https://www.aliexpress.com/item/1005010046279521.html) |  |  |  | 2026-11-05
M08 | Motion | Disc or bellows coupling 10 mm to 10 mm | 3 | pcs | Listings give a 10 mm shaft on the 4 Nm NEMA 24 (24HS40-5004D-E1000). Verify. BK12 end is 10 mm | 3 × £3.35 + £4.05 (AliExpress, logged in) | £14.10 | AliExpress (https://www.aliexpress.com/item/1005009879991986.html) |  |  | D26 L35 double diaphragm, 10 × 10 bore. All 3 motors confirmed 10 mm shaft | 2026-11-08
M09 | Motion | NEMA 24 closed-loop stepper + driver about 4 Nm | 2 | sets | X and Y. Candidate: StepperOnline 1-CL57T-S40-V41 (24HS40-5004D-E1000 + CL57T V4.1 / 24-48 V DC / 1000 PPR encoder) | £51.34 (VAT?) per set + £10.03 UK warehouse (StepperOnline) | £112.71 | StepperOnline (https://www.omc-stepperonline.com/ts-series-4-0-nm-566-56oz-in-1-axis-closed-loop-stepper-cnc-kit-nema-24-motor-driver-1-cl57t-s40-v41) |  |  | 24HS40-5004D-E1000 + CL57T-V41. Shaft 10 mm D-cut. UK stock 5. VAT basis unclear | 2026-11-05
M10 | Motion | NEMA 24 closed-loop stepper with 24 V brake | 1 | set | StepperOnline 24HS34-5004D-E1000-B280: 3 Nm / 5 A / 1000 PPR encoder / 2.8 Nm 24 V power-off brake | £59.22 (VAT?) (StepperOnline) | £59.22 | StepperOnline (https://www.omc-stepperonline.com/s-series-nema-24-closed-loop-stepper-motor-3-0nm-424-92oz-in-with-2-8nm-396-51oz-in-electromagnetic-brake-24hs34-5004d-e1000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) |  |  | China warehouse only, backorder, est. 13-19 Nov. Shaft 10 mm D-cut. Shipping not shown | 2026-11-05
M14 | Motion | CL57T V4.1 closed-loop driver | 1 | pcs | For the Z brake motor. 24-48 V DC / 0-8 A | £28.75 (VAT?) + £5.47 DE warehouse (StepperOnline) | £34.22 | StepperOnline (https://www.omc-stepperonline.com/closed-loop-stepper-driver-v4-1-0-8-0a-24-48vdc-for-nema-17-23-24-stepper-motor-cl57t-v41) |  |  | No UK stock | 2026-11-05
M11 | Motion | Table plate 6082 460 × 330 × 25 | 1 | pcs | 6082 aluminium 460 × 330 × 25 mm (D-79) | £184.44 ex VAT, 6082 460 × 330 × 25 custom cut (Aluminium Warehouse) | £221.33 | Aluminium Warehouse (https://www.aluminiumwarehouse.co.uk/products/25-mm-6082-aluminium-plate) |  |  | D-79. Inc VAT calculated. Order with M12 + A06 (free delivery over £150 ex VAT unless SA2 is excluded). Cast tooling plate £251.04 ex VAT | 2026-11-07
M12 | Motion | Saddle + Z plates 6082 20 mm | 1 | lot | 6082 20 mm: saddle about 180 × 160, Z plate about 140 × 320 (v2) | £27.99 (180 × 160 × 20) + £43.55 (320 × 140 × 20) ex VAT (Aluminium Warehouse) | £85.85 | Aluminium Warehouse (https://www.aluminiumwarehouse.co.uk/products/20-mm-6082-aluminium-plate) |  |  | Same order as M11. Inc VAT calculated | 2026-11-07
M13 | Motion | Motor and bearing mounts | 1 | lot | Machined or bought brackets | 3 × £9.99 + £25.19 shipping (AliExpress, logged in) | £55.16 | AliExpress (https://www.aliexpress.com/item/1005006232398099.html) |  |  | Earlier price counted shipping for one bracket only | 2026-11-08
S08 | Spindle | G-Penny 2.2 kW ER20 water-cooled spindle kit | 1 | pcs | BST2.2C-80-24K: 2.2 kW, 220 V, 400 Hz, 24,000 rpm, 0.88 Nm, ER20, Ø80 × 230 (+52 nose), 5.5 kg, runout 0.005 mm, bearings 2 × 7005C + 2 × 7002C P4 DT. Kit: Huanyang 2.2 kW VFD (220 V 1-ph in, 0-400 Hz), 80 mm clamp, 75 W 220 V pump + 5 m hose, ER20 collets 4/6/8/10/12 mm + 1/8, 1/4, 1/2 in | £217.39 + £100.77 shipping (owner, AliExpress), delivery 8 Jan | £318.16 | AliExpress (https://www.aliexpress.com/item/32253760001.html) |  |  | D-78. Known maker with stated runout and P4 bearings. Shipping is heavy (about 9 kg kit): a UK/EU-stock seller may be cheaper or faster | 2026-11-07
S09 | Spindle | ER20 collet set | 1 | set | 13 × ER20 collets 1-13 mm, AA 0.008 mm, boxed + ER20A spanner | Collets £27.79 + spanner £3.25 (AliExpress, logged in) | £31.04 | AliExpress (https://www.aliexpress.com/item/1005010595086817.html) |  |  | Small sizes (1-3 mm) not in the kit collets: keep for small tools. Spanner may come with the kit: check | 2026-11-08
S02 | Spindle | VFD (included in the G-Penny kit, S08) | 1 | pcs | 2.2 kW, 1-phase 220 V in, 3-phase 220 V out, 0-600 Hz, RS-485 Modbus-RTU stated | Included in S08 | £0.00 | AliExpress (https://www.aliexpress.com/item/32253760001.html) |  |  | D-78. Huanyang HY: Modbus over RS-485 via LinuxCNC hy_vfd / Mesa RS-485 (D-32, D-58). Previous ZEST VFD £88.94 no longer needed | 2026-11-07
S03 | Spindle | 80 mm spindle clamp (included in S08) | 1 | pcs | 80 mm | Included in S08 | £0.00 | AliExpress (https://www.aliexpress.com/item/32253760001.html) |  |  | D-78 | 2026-11-07
S04 | Spindle | Screened 4-core cable 16 AWG, 4 × 5 m (spindle + 3 motors) | 4 | × 5 m |  | £19.03 each inc VAT, free shipping (AliExpress) | £76.12 | AliExpress (https://www.aliexpress.com/item/32971008305.html) |  |  | D-84: premium accepted. Covers E20. 16 AWG ≈ 1.3 mm² | 2026-11-08
S05 | Spindle | Spindle cooling loop (DIY) | 1 | pcs | Kit 220 V pump (S08) in a sealed reservoir; 240 mm radiator G1/4; 2 × 120 mm 12 V fans (in series on 24 V); 2 × 8 mm × 1/4 barbs; 60 hose clamps; brass flow switch G1/4 NO 1.5-3 L/min; 5 m 8 mm ID braided PVC hose | Radiator £13.35 + basket fans £8.70, barbs £2.38, clamps £17.89 + flow switch £12.51 (AliExpress) + 8 mm ID hose £8.99 (B&Q marketplace, free delivery) | £63.82 | AliExpress (https://www.aliexpress.com/item/1005007038307491.html) | AliExpress (https://www.aliexpress.com/item/1005010428362103.html) | B&Q (https://www.diy.com/departments/clear-pvc-braided-hose-food-grade-oil-water-fuel-reinforced-pipe-tube-8mm-internal-12mm-external-5m-/5060449706401_BQ.prd) | D-85. Flow switch: (contact rating not stated: check before wiring to a 7i76EU input). Hose: . Remove the 6 mm ID tube from the AliExpress basket | 2026-11-08
E01 | Electronics | Mesa 7i76EU | 1 | pcs |  | €309.31 = £257.74 incl. import VAT (owner-confirmed price, not yet bought) | £257.74 | Mesa store (https://store.mesanet.com/index.php?route=product/product&product_id=399) |  |  | Price includes import VAT. Order in wave 1 (week 1) | 2026-11-05
E02 | Electronics | Mini-PC (owner already has) | 1 | pcs |  | Owner sourced | £0.00 | owner / DIY / included |  |  | D-58. Onboard Intel NIC goes to the Mesa board. No 2nd NIC: machine stays offline | 2026-11-05
E03 | Electronics | Monitor + keyboard + mouse (owner already has) | 1 | set |  | Owner sourced | £0.00 | owner / DIY / included |  |  | D-58 | 2026-11-05
E04 | Electronics | 48 V PSU Mean Well SDR-480-48 (DIN) | 1 | pcs | Mean Well SDR-480-48, 48 V 10 A 480 W, DIN rail | £113.38 ex / £136.06 inc VAT (RS 042-4868) | £136.06 | rs-online.com (https://uk.rs-online.com/web/p/switching-power-supplies/0424868) |  |  | D-84. RS free delivery over £60 | 2026-11-08
E05 | Electronics | 24 V DC PSU, DIN rail (Mean Well HDR-150-24) | 1 | pcs | Mean Well HDR-150-24, DIN rail | £27.62 (VAT?), pre-order (StepperOnline, read 2026-11-05) | £27.62 | StepperOnline (https://www.omc-stepperonline.com/hdr-150-24-mean-well-24vdc-5-31a-127-4w-115vac-6-25a-150w-230vac-ultra-slim-step-shape-din-rail-power-supply-hdr-150-24) |  |  | D-84: kept at StepperOnline (already a vendor, genuine). Was pre-order: check stock | 2026-11-08
E23 | Electronics | Coolant pump relay (DIN interface relay, 24 V DC coil) | 1 | pcs | DIN-rail interface relay, 24 V DC coil, 1 CO, about 10 A 250 V AC contact, with LED (e.g. Finder 38/39 series) | TO PRICE (RS) |  | rs-online.com (https://uk.rs-online.com/) |  |  | Switches the 220 V kit pump from Mesa OUT2
E06 | Electronics | E-stop safety relay Schneider Preventa XPSAC5121 | 1 | pcs | 24 V AC/DC, e-stop monitoring, 1 or 2 channel, manual reset | £84.39 inc VAT, free shipping (AliExpress, 107 sold) | £84.39 | AliExpress (https://www.aliexpress.com/item/1005012583131933.html) |  |  | D-84: premium accepted (no eBay). Genuine part not verified. Wire each e-stop's 2 NC contacts as two channels; reset button to the reset input; safety outputs to the E07 coil | 2026-11-08
E07 | Electronics | Contactor with 24 V coil | 1 | pcs |  | £26.29 inc VAT, free shipping (AliExpress, logged in) | £26.29 | AliExpress (https://www.aliexpress.com/item/1005005356561757.html) |  |  | Schneider LC1D09BDC 24 V DC coil. Genuine not verified | 2026-11-08
E08 | Electronics | E-stop buttons 2 NC (×5) | 1 | set | XB2-BS544 22 mm, 2 NC, twist release (2 NC for the dual-channel relay) | £12.39 inc VAT for 5, free shipping (AliExpress, option BS544-2NC) | £12.39 | AliExpress (https://www.aliexpress.com/item/1005008293871583.html) |  |  | D-84: 2 NC needed for dual-channel E06 | 2026-11-08
E09 | Electronics | MCBs / main isolator / EMC filter for VFD | 1 | set |  | £10.39 inc VAT, free shipping (AliExpress) | £10.39 | AliExpress (https://www.aliexpress.com/item/1005010519550019.html) |  |  | CW4L2-20A-S. MCBs and isolator NOT priced | 2026-11-08
E10 | Electronics | Inductive proximity switches 24 V | 5 | pcs | LJ12A3-4-Z/BY M12 PNP NO 4 mm (4 homing + 1 for the ATC wheel index, A09) | £1.54 each + £6.92 shipping for 5 (AliExpress, logged in) | £12.20 | AliExpress (https://www.aliexpress.com/item/1005010648075147.html) |  |  | Includes the A09 sensor (its extra £2.42 is counted on A09, Phase 3) | 2026-11-08
E12 | Electronics | Electrical cabinet RS PRO 600 × 400 × 200 IP66 | 1 | set | RS PRO steel wall box IP66 600 × 400 × 200, chassis plate, gland plate | £90.87 ex / £109.04 inc VAT (RS 775-5817) | £109.04 | rs-online.com (https://uk.rs-online.com/web/p/wall-boxes/7755817) |  |  | Owner decision 8 Nov: keep 600 × 400 (premium accepted) | 2026-11-08
E13 | Electronics | DIN rail, terminals, end stops, ferrules + crimper, wire | 1 | lot | 2 × 500 mm DIN rail, HSC8 6-4 crimper + 300 ferrules, BVR 1.5 mm² 10 m (mains), UL1007 18 AWG 10 m (24 V only); RS 30 × 2.5 mm² terminals + 5 end stops | AliExpress: rail 2 × £5.51, crimper kit £7.83, 1.5 mm² £16.69, 18 AWG £3.65. RS: terminals £10.56, end stops £2.51 | £52.26 | AliExpress (https://www.aliexpress.com/item/4000151397971.html) | AliExpress (https://www.aliexpress.com/item/1005012223962740.html) | AliExpress (https://www.aliexpress.com/item/1005011853538687.html) | Crimper kit ; 1.5 mm² ; 18 AWG ; RS terminals . Covers E19 | 2026-11-08
E14 | Electronics | Cable chain and shielded motor cables | 1 | lot |  | £15.79 inc VAT, free shipping (AliExpress) | £15.79 | AliExpress (https://www.aliexpress.com/item/1005012723966521.html) |  |  | 1 m only: length TBD. Shielded motor cable NOT priced | 2026-11-08
E17 | Electronics | Isolator + MCBs | 1 | set | EARU 2P 40 A isolator + CHINT NXB-63 1P C16 + 2 × C6 | Isolator £4.43 + C16 £3.82 + 2 × C6 £3.95 inc VAT (AliExpress) | £16.15 | AliExpress (https://www.aliexpress.com/item/1005006908131326.html) | AliExpress (https://www.aliexpress.com/item/1005002971655457.html) |  | MCBs: (order ≥ £8: free shipping). Isolator alone under £8: fee not shown | 2026-11-08
E18 | Electronics | Cabinet filter fan + exhaust grille (9803 series) | 1 | set | 9803-230 120 mm 230 V filter fan + 9803-300 exhaust grille | Fan £7.41 + £9.93 shipping, grille £4.99 (AliExpress) | £22.33 | AliExpress (https://www.aliexpress.com/item/1005003027013500.html) | AliExpress (https://www.aliexpress.com/item/32884649030.html) |  | Grille: . Same series, cutouts match | 2026-11-08
E19 | Electronics | (covered by E13) | 1 | set | 1 m DIN, ferrule kit + crimper, 0.75 and 1.5 mm² wire 10 m each | Included in E13 | £0.00 | owner / DIY / included |  |  |  | 2026-11-08
E20 | Electronics | (covered by S04) | 15 | m | CY 4-core 1.0 mm² | Included in S04 | £0.00 | owner / DIY / included |  |  |  | 2026-11-08
E21 | Electronics | Reset button 22 mm green (in your basket) | 1 | pcs | 22 mm green, 2 NO, momentary, 24 V LED | £4.25 inc VAT (AliExpress basket, Sweideer) | £4.25 | AliExpress (https://www.aliexpress.com/item/1005006872683640.html) |  |  | Already in your AliExpress basket | 2026-11-08
T01 | Stand | Bench (owner-built timber) | 1 | lot | Owner-built timber bench, top 785 mm above the floor, carries about 150 kg + enclosure | Owner build | £0.00 | owner / DIY / included |  |  | D-71 | 2026-11-06
T02 | Stand | Anti-vibration feet | 4 | pcs | 4 × RS PRO levelling foot M10 × 45, 50 mm polyamide base, 470 kg | £10.16 ex / £12.19 inc VAT (RS 028-5757) | £12.19 | rs-online.com (https://uk.rs-online.com/web/p/adjustable-feet/0285757) |  |  | Polyamide base, not rubber: add rubber pads if needed for vibration | 2026-11-08
X01 | Metrology | Dial test indicator + magnetic base | 1 | set | For rail alignment and squaring the gantry | £17.23 inc VAT, free shipping (AliExpress) | £17.23 | AliExpress (https://www.aliexpress.com/item/1005013036061506.html) |  |  | Lever DTI 0.01 mm + flexible base | 2026-11-08
X02 | Metrology | Precision level 200 mm (AliExpress) | 1 | pcs | 200 mm bar level, title "0.02 mm" (per-metre not stated) | £15.69 + £17.25 shipping (AliExpress) | £32.94 | AliExpress (https://www.aliexpress.com/item/32814850915.html) |  |  | D-84: owner choice. Sensitivity unit not confirmed | 2026-11-08
X03 | Fixings | Socket cap screws (M5/M6/M8/M10/M12) | 1 | lot | M5 × 16 (100) + M6 × 20 (50) A2 [Screwfix]; M10 × 30 12.9 (20) [AliExpress]; M8 × 25 (50) + M12 × 120 (10) [RS] | Screwfix 2 × £5.79 + £7.59; AliExpress 10 × £1.52; RS £11.96 + £24.14 | £70.47 | Screwfix (https://www.screwfix.com/) | AliExpress (https://www.aliexpress.com/item/4000784829771.html) |  | Screwfix 4366T, 5209T; AliExpress ; RS 052-9725, 124-7302. Covers X04 | 2026-11-08
X04 | Fixings | (covered by X03) | 1 | set | 100 × M5 × 16 + 10 × M12 × 120, grade 12.9 | Included in X03 | £0.00 | owner / DIY / included |  |  |  | 2026-11-08
 |  |  |  |  |  | Phase 1 total
 |  |  |  |  |  | Budget (D-68) | £4000.00
 |  |  |  |  |  | Remaining
 |  |  |  |  |  | Bought so far (lines marked Y)

Sheet: Summary
Subsystem | Line £ | Actual paid £
Frame
Motion
Spindle
Electronics
Stand
Metrology
Fixings
Total
