yousef-chitani/Type_0_CNC/cad/out/type0.step

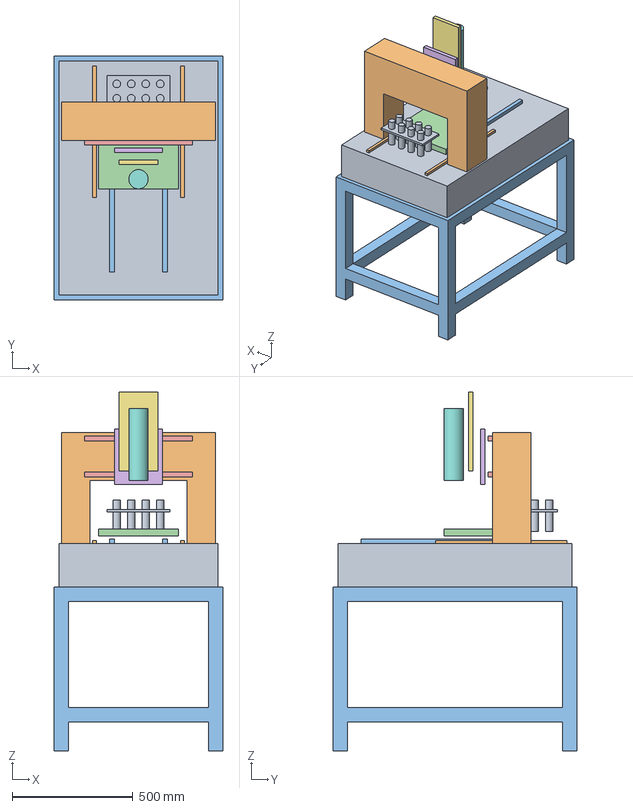
[picture p7: CAD file, 2026-11-05]
cad/out/type0.step
700.0 x 1010.0 x 1487.5 mm
base
gantry
y_rail_-1
y_rail_1
table
x_rail_-1
x_rail_1
saddle
z_plate
spindle
rack
rack_rail_-1
rack_rail_1
stand
