yousef-chitani/Type_0_CNC/cad/v2/out/type0_v2_with_enclosure.step

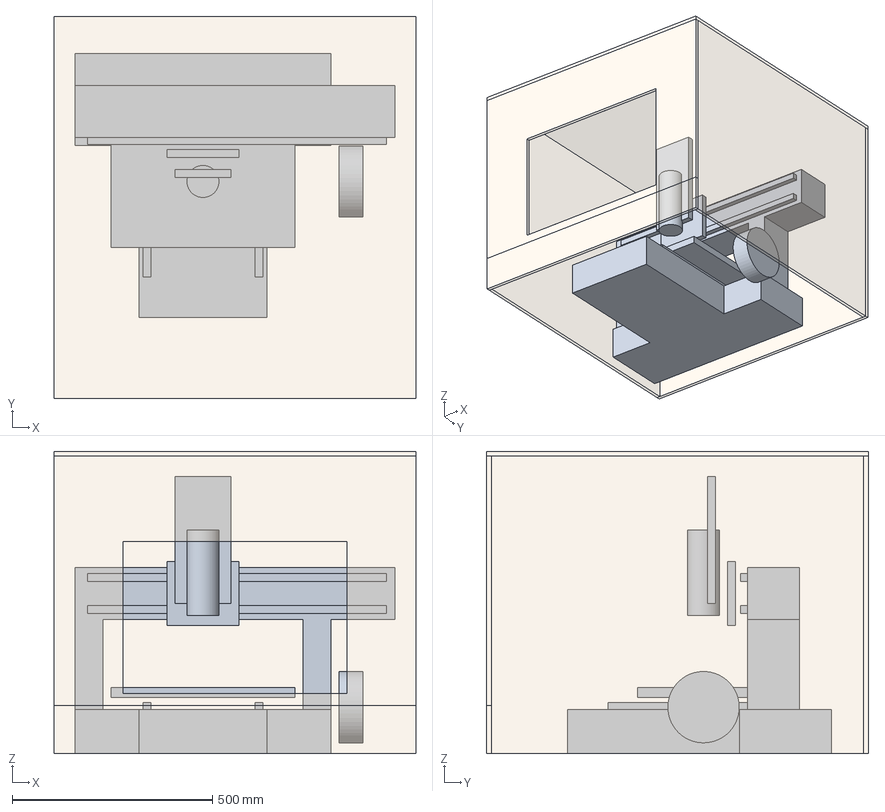
[picture p8: CAD file, 2026-11-08]
cad/v2/out/type0_v2_with_enclosure.step
904.0 x 954.0 x 754.5 mm
base
portal
y_rail-1
y_rail1
table
x_rail-1
x_rail1
saddle
z_plate
spindle
atc_wheel
encl_top
encl_back
encl_side_l
encl_side_r
encl_front_strip
encl_door
