yousef-chitani/Type_0_CNC/cad/v2/out/type0_v2.step

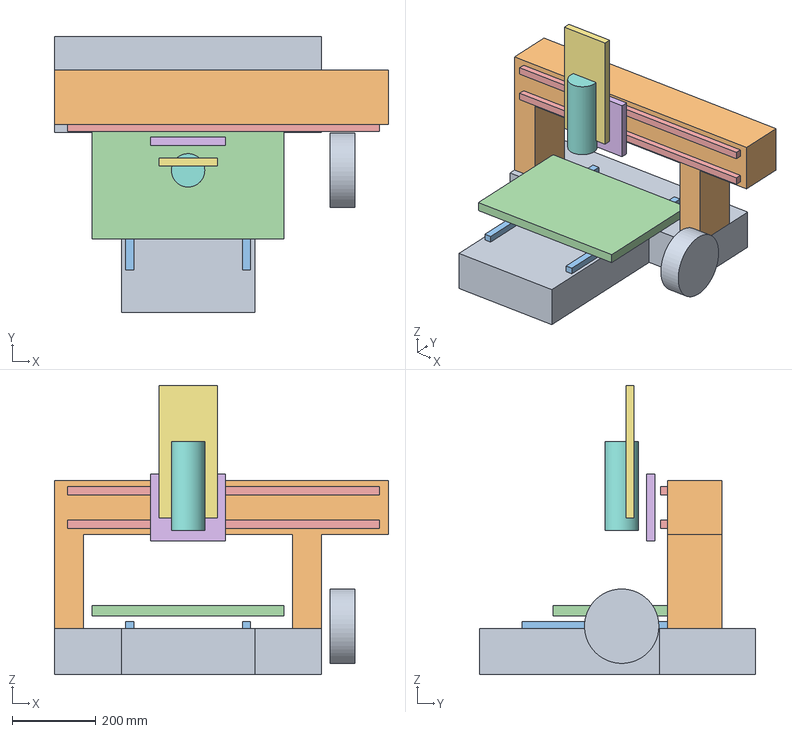
[picture p9: CAD file, 2026-11-07]
cad/v2/out/type0_v2.step
800.0 x 660.0 x 692.5 mm
base
portal
y_rail-1
y_rail1
table
x_rail-1
x_rail1
saddle
z_plate
spindle
atc_wheel
