yousef-chitani/Type_0_CNC/tools/open_links.py

#!/usr/bin/env python3
"""Shop the Type 0 CNC parts list one vendor at a time (standalone: the links are built in).

    py open_links.py               # Phase 1, vendor by vendor
    py open_links.py --phase 2     # or 1,2 or all
    py open_links.py --with-alts   # also open alternative-supplier links
    py open_links.py --list        # print the shopping list, open nothing

For each vendor it prints what to buy (ID, item, qty, budget), opens that vendor's
product pages as Firefox tabs, then waits. Add everything to the basket, close the
product tabs (keep the basket tab), then press Enter for the next vendor.
Keys at the prompt: Enter = next vendor, q = quit.
eBay links are never opened (vendor policy D-82).
"""
import argparse, json, os, shutil, subprocess, sys, time, webbrowser

PARTS = json.loads(r"""[{"id": "F01", "phase": "1", "item": "Main EG epoxy: GlassCast 50 PLUS 15 kg", "qty": "1 kit", "price": "255.00", "vendor": "Easy Composites", "url": "https://www.easycomposites.co.uk/glasscast-50-plus-clear-epoxy-casting-resin", "extra": []}, {"id": "F02", "phase": "1", "item": "Epoxy for leveling pour / grout / samples", "qty": "5 kg", "price": "91.75", "vendor": "Easy Composites", "url": "https://www.easycomposites.co.uk/glasscast-50-plus-clear-epoxy-casting-resin", "extra": []}, {"id": "F03", "phase": "1", "item": "Coarse aggregate: quartz 2-5 mm", "qty": "2 25 kg bags", "price": "29.04", "vendor": "GCL", "url": "https://www.gclproducts.co.uk/p/resin-bound-gravel/winter-quartz-2-5mm-gravel", "extra": []}, {"id": "F04", "phase": "1", "item": "Medium + fine: kiln-dried sand 0-1 mm", "qty": "3 20 kg bags", "price": "19.14", "vendor": "Hancock & Brown", "url": "https://hancockandbrown.com/kiln-dried-block-paving-sand-20kg-bag", "extra": []}, {"id": "F06", "phase": "1", "item": "Filler: whiting (calcium carbonate powder)", "qty": "1 25 kg bag", "price": "20.42", "vendor": "Valentine Clays", "url": "https://valentineclays.co.uk/products/whiting", "extra": []}, {"id": "F07", "phase": "1", "item": "Steel flat bar 40 x 10 mm", "qty": "1 3 m bar", "price": "36.00", "vendor": "The Metal Store", "url": "https://www.themetalstore.co.uk/products/3-metre-lengths-10mm-flat-bar", "extra": []}, {"id": "F08", "phase": "1", "item": "M12 threaded rod 2 × 1 m + nuts", "qty": "1 lot", "price": "29.08", "vendor": "Screwfix", "url": "https://www.screwfix.com/p/easyfix-bzp-steel-threaded-rods-m12-x-1000mm-5-pack/98942", "extra": ["https://www.screwfix.com/p/easyfix-bzp-steel-hex-nuts-m12-100-pack/15569"]}, {"id": "F09", "phase": "1", "item": "Steel or PVC tube for M12 bolt sleeves", "qty": "2 m", "price": "2.29", "vendor": "Screwfix", "url": "https://www.screwfix.com/p/deta-tte-round-upvc-white-conduit-20mm-x-3m/256vt", "extra": []}, {"id": "F11", "phase": "1", "item": "CLS timber 38 x 63 x 2400 (mould bracing)", "qty": "6 lengths", "price": "23.82", "vendor": "B&Q", "url": "https://www.diy.com/departments/essentials-smooth-planed-c16-whitewood-spruce-cls-timber-l-2-4m-w-63mm-t-38mm/1798294_BQ.prd", "extra": []}, {"id": "F12", "phase": "1", "item": "Release agents (Easy Composites)", "qty": "1 set", "price": "14.90", "vendor": "Easy Composites", "url": "https://www.easycomposites.co.uk/pva-mould-release-agent", "extra": ["https://www.easycomposites.co.uk/number-8-mould-release-wax"]}, {"id": "F17", "phase": "1", "item": "Mixer", "qty": "1 pcs", "price": "69.99", "vendor": "Screwfix", "url": "https://www.screwfix.com/p/erbauer-epm1600-1600w-electric-paddle-mixer-220-240v/981kj", "extra": []}, {"id": "F18", "phase": "1", "item": "Silicone (Screwfix) + packing tape (AliExpress)", "qty": "1 set", "price": "17.69", "vendor": "Screwfix", "url": "https://www.screwfix.com/p/no-nonsense-291-builders-silicone-clear-310ml/83710", "extra": ["https://www.aliexpress.com/item/1005006967362821.html"]}, {"id": "M01", "phase": "1", "item": "HGR20 rail kit Y: 2 × 500 mm + 4 blocks", "qty": "2 pcs", "price": "64.79", "vendor": "AliExpress", "url": "https://www.aliexpress.com/item/1005010242098397.html", "extra": []}, {"id": "M02", "phase": "1", "item": "HGR20 rail kit X: 2 × 800 mm + 4 blocks", "qty": "2 pcs", "price": "81.99", "vendor": "AliExpress", "url": "https://www.aliexpress.com/item/1005010242098397.html", "extra": []}, {"id": "M03", "phase": "1", "item": "HGR20 rail kit Z: 2 × 350 mm + 4 blocks", "qty": "2 pcs", "price": "60.59", "vendor": "AliExpress", "url": "https://www.aliexpress.com/item/1005010242098397.html", "extra": []}, {"id": "M05", "phase": "1", "item": "DFU1605 ballscrew kits X 750 / Y 450 / Z 350", "qty": "3 pcs", "price": "214.81", "vendor": "AliExpress", "url": "https://www.aliexpress.com/item/1005010046279521.html", "extra": []}, {"id": "M06", "phase": "1", "item": "BK12 + BF12 end supports (in the screw kits)", "qty": "3 sets", "price": "0", "vendor": "AliExpress", "url": "https://www.aliexpress.com/item/1005010046279521.html", "extra": []}, {"id": "M07", "phase": "1", "item": "Nut housings (in the screw kits)", "qty": "3 pcs", "price": "0", "vendor": "AliExpress", "url": "https://www.aliexpress.com/item/1005010046279521.html", "extra": []}, {"id": "M08", "phase": "1", "item": "Disc or bellows coupling 10 mm to 10 mm", "qty": "3 pcs", "price": "14.10", "vendor": "AliExpress", "url": "https://www.aliexpress.com/item/1005009879991986.html", "extra": []}, {"id": "M09", "phase": "1", "item": "NEMA 24 closed-loop stepper + driver about 4 Nm", "qty": "2 sets", "price": "112.71", "vendor": "StepperOnline", "url": "https://www.omc-stepperonline.com/ts-series-4-0-nm-566-56oz-in-1-axis-closed-loop-stepper-cnc-kit-nema-24-motor-driver-1-cl57t-s40-v41", "extra": []}, {"id": "M10", "phase": "1", "item": "NEMA 24 closed-loop stepper with 24 V brake", "qty": "1 set", "price": "59.22", "vendor": "StepperOnline", "url": "https://www.omc-stepperonline.com/s-series-nema-24-closed-loop-stepper-motor-3-0nm-424-92oz-in-with-2-8nm-396-51oz-in-electromagnetic-brake-24hs34-5004d-e1000-b280", "extra": []}, {"id": "M14", "phase": "1", "item": "CL57T V4.1 closed-loop driver", "qty": "1 pcs", "price": "34.22", "vendor": "StepperOnline", "url": "https://www.omc-stepperonline.com/closed-loop-stepper-driver-v4-1-0-8-0a-24-48vdc-for-nema-17-23-24-stepper-motor-cl57t-v41", "extra": []}, {"id": "M11", "phase": "1", "item": "Table plate 6082 460 × 330 × 25", "qty": "1 pcs", "price": "221.33", "vendor": "Aluminium Warehouse", "url": "https://www.aluminiumwarehouse.co.uk/products/25-mm-6082-aluminium-plate", "extra": []}, {"id": "M12", "phase": "1", "item": "Saddle + Z plates 6082 20 mm", "qty": "1 lot", "price": "85.85", "vendor": "Aluminium Warehouse", "url": "https://www.aluminiumwarehouse.co.uk/products/20-mm-6082-aluminium-plate", "extra": []}, {"id": "M13", "phase": "1", "item": "Motor and bearing mounts", "qty": "1 lot", "price": "55.16", "vendor": "AliExpress", "url": "https://www.aliexpress.com/item/1005006232398099.html", "extra": []}, {"id": "S01", "phase": "2", "item": "Jianken JGL-80/2.2R24-20 ATC spindle", "qty": "1 pcs", "price": "990.57", "vendor": "Alibaba", "url": "https://www.alibaba.com/product-detail/Jianken-JGL-80-2-2KW-24000RPM_1601249825246.html", "extra": ["https://www.aliexpress.com/item/1005010706946690.html"]}, {"id": "S08", "phase": "1", "item": "G-Penny 2.2 kW ER20 water-cooled spindle kit", "qty": "1 pcs", "price": "318.16", "vendor": "AliExpress", "url": "https://www.aliexpress.com/item/32253760001.html", "extra": []}, {"id": "S09", "phase": "1", "item": "ER20 collet set", "qty": "1 set", "price": "31.04", "vendor": "AliExpress", "url": "https://www.aliexpress.com/item/1005010595086817.html", "extra": []}, {"id": "S02", "phase": "1", "item": "VFD (included in the G-Penny kit, S08)", "qty": "1 pcs", "price": "0.00", "vendor": "AliExpress", "url": "https://www.aliexpress.com/item/32253760001.html", "extra": []}, {"id": "S03", "phase": "1", "item": "80 mm spindle clamp (included in S08)", "qty": "1 pcs", "price": "0.00", "vendor": "AliExpress", "url": "https://www.aliexpress.com/item/32253760001.html", "extra": []}, {"id": "S04", "phase": "1", "item": "Screened 4-core cable 16 AWG, 4 × 5 m (spindle + 3 motors)", "qty": "4 × 5 m", "price": "76.12", "vendor": "AliExpress", "url": "https://www.aliexpress.com/item/32971008305.html", "extra": []}, {"id": "S05", "phase": "1", "item": "Spindle cooling loop (DIY)", "qty": "1 pcs", "price": "63.82", "vendor": "AliExpress", "url": "https://www.aliexpress.com/item/1005007038307491.html", "extra": ["https://www.aliexpress.com/item/1005010428362103.html", "https://www.diy.com/departments/clear-pvc-braided-hose-food-grade-oil-water-fuel-reinforced-pipe-tube-8mm-internal-12mm-external-5m-/5060449706401_BQ.prd"]}, {"id": "S06", "phase": "2", "item": "ISO20 ER16 holders with pull studs", "qty": "8 pcs", "price": "48.40", "vendor": "AliExpress", "url": "https://www.aliexpress.com/item/4000141590118.html", "extra": []}, {"id": "S07", "phase": "2", "item": "ER16 collet set", "qty": "1 set", "price": "17.89", "vendor": "AliExpress", "url": "https://www.aliexpress.com/item/1005005626185405.html", "extra": []}, {"id": "A03", "phase": "2", "item": "Small closed-loop stepper + driver (48 V)", "qty": "1 set", "price": "47.77", "vendor": "StepperOnline", "url": "https://www.omc-stepperonline.com/1-axis-closed-loop-stepper-cnc-kit-80ncm-113-29oz-in-nema-17-motor-driver-1-cl42t-s08-v41", "extra": []}, {"id": "A05", "phase": "2", "item": "Tool length setter (wired switch)", "qty": "1 pcs", "price": "17.89", "vendor": "AliExpress", "url": "https://www.aliexpress.com/item/1005012101891449.html", "extra": []}, {"id": "A06", "phase": "2", "item": "ATC wheel discs + bracket", "qty": "1 lot", "price": "55.32", "vendor": "Aluminium Warehouse", "url": "https://www.aluminiumwarehouse.co.uk/products/8-mm-6082-aluminium-plate", "extra": []}, {"id": "A07", "phase": "2", "item": "ATC wheel shaft + 2 bearings", "qty": "1 set", "price": "21.74", "vendor": "AliExpress", "url": "https://www.aliexpress.com/item/1005007995333691.html", "extra": ["https://www.aliexpress.com/item/1005007098430647.html"]}, {"id": "A08", "phase": "2", "item": "ATC wheel drive reduction", "qty": "1 set", "price": "9.32", "vendor": "AliExpress", "url": "https://www.aliexpress.com/item/32650791423.html", "extra": []}, {"id": "A09", "phase": "2", "item": "ATC wheel index sensor", "qty": "1 set", "price": "2.42", "vendor": "AliExpress", "url": "https://www.aliexpress.com/item/1005010648075147.html", "extra": []}, {"id": "P01", "phase": "2", "item": "Filter / regulator / dryer", "qty": "1 pcs", "price": "6.50", "vendor": "AliExpress", "url": "https://www.aliexpress.com/item/1005002589702135.html", "extra": []}, {"id": "P02", "phase": "2", "item": "24 V solenoid valves", "qty": "4 pcs", "price": "37.96", "vendor": "AliExpress", "url": "https://www.aliexpress.com/item/1005012294513653.html", "extra": []}, {"id": "P03", "phase": "2", "item": "Air pressure switch", "qty": "1 pcs", "price": "8.96", "vendor": "AliExpress", "url": "https://www.aliexpress.com/item/1005013285557375.html", "extra": []}, {"id": "P04", "phase": "2", "item": "Mist coolant system with 24 V solenoid", "qty": "1 set", "price": "17.59", "vendor": "AliExpress", "url": "https://www.aliexpress.com/item/1005012241646016.html", "extra": []}, {"id": "P05", "phase": "2", "item": "Push-fit tubing and fittings 6/8 mm", "qty": "1 lot", "price": "11.87", "vendor": "AliExpress", "url": "https://www.aliexpress.com/item/1005006780298909.html", "extra": []}, {"id": "P06", "phase": "2", "item": "Push-in fittings", "qty": "12 pcs", "price": "27.34", "vendor": "RS Components", "url": "https://uk.rs-online.com/web/p/pneumatic-fittings/2993932", "extra": ["https://uk.rs-online.com/web/p/pneumatic-fittings/7042758"]}, {"id": "E01", "phase": "1", "item": "Mesa 7i76EU", "qty": "1 pcs", "price": "257.74", "vendor": "Mesa", "url": "https://store.mesanet.com/index.php?route=product/product&product_id=399", "extra": []}, {"id": "E04", "phase": "1", "item": "48 V PSU Mean Well SDR-480-48 (DIN)", "qty": "1 pcs", "price": "136.06", "vendor": "RS Components", "url": "https://uk.rs-online.com/web/p/switching-power-supplies/0424868", "extra": []}, {"id": "E05", "phase": "1", "item": "24 V DC PSU, DIN rail (Mean Well HDR-150-24)", "qty": "1 pcs", "price": "27.62", "vendor": "StepperOnline", "url": "https://www.omc-stepperonline.com/hdr-150-24-mean-well-24vdc-5-31a-127-4w-115vac-6-25a-150w-230vac-ultra-slim-step-shape-din-rail-power-supply-hdr-150-24", "extra": []}, {"id": "E22", "phase": "1", "item": "5 V DC PSU, DIN rail (Mean Well MDR-10-5)", "qty": "1 pcs", "price": "15.65", "vendor": "RS Components", "url": "https://uk.rs-online.com/web/p/din-rail-power-supplies/7127402", "extra": []}, {"id": "E06", "phase": "1", "item": "E-stop safety relay Schneider Preventa XPSAC5121", "qty": "1 pcs", "price": "84.39", "vendor": "AliExpress", "url": "https://www.aliexpress.com/item/1005012583131933.html", "extra": []}, {"id": "E07", "phase": "1", "item": "Contactor with 24 V coil", "qty": "1 pcs", "price": "26.29", "vendor": "AliExpress", "url": "https://www.aliexpress.com/item/1005005356561757.html", "extra": []}, {"id": "E08", "phase": "1", "item": "E-stop buttons 2 NC (×5)", "qty": "1 set", "price": "12.39", "vendor": "AliExpress", "url": "https://www.aliexpress.com/item/1005008293871583.html", "extra": []}, {"id": "E09", "phase": "1", "item": "MCBs / main isolator / EMC filter for VFD", "qty": "1 set", "price": "10.39", "vendor": "AliExpress", "url": "https://www.aliexpress.com/item/1005010519550019.html", "extra": []}, {"id": "E10", "phase": "1", "item": "Inductive proximity switches 24 V", "qty": "5 pcs", "price": "12.20", "vendor": "AliExpress", "url": "https://www.aliexpress.com/item/1005010648075147.html", "extra": []}, {"id": "E12", "phase": "1", "item": "Electrical cabinet RS PRO 600 × 400 × 200 IP66", "qty": "1 set", "price": "109.04", "vendor": "RS Components", "url": "https://uk.rs-online.com/web/p/wall-boxes/7755817", "extra": []}, {"id": "E13", "phase": "1", "item": "DIN rail, terminals, end stops, ferrules + crimper, wire", "qty": "1 lot", "price": "52.26", "vendor": "AliExpress", "url": "https://www.aliexpress.com/item/4000151397971.html", "extra": ["https://www.aliexpress.com/item/1005012223962740.html", "https://www.aliexpress.com/item/1005011853538687.html", "https://www.aliexpress.com/item/1005011594190524.html", "https://uk.rs-online.com/web/p/din-rail-terminal-blocks/8787503"]}, {"id": "E14", "phase": "1", "item": "Cable chain and shielded motor cables", "qty": "1 lot", "price": "15.79", "vendor": "AliExpress", "url": "https://www.aliexpress.com/item/1005012723966521.html", "extra": []}, {"id": "E15", "phase": "2", "item": "Enclosure door switch", "qty": "1 pcs", "price": "8.07", "vendor": "AliExpress", "url": "https://www.aliexpress.com/item/1005006072968001.html", "extra": []}, {"id": "E17", "phase": "1", "item": "Isolator + MCBs", "qty": "1 set", "price": "16.15", "vendor": "AliExpress", "url": "https://www.aliexpress.com/item/1005006908131326.html", "extra": ["https://www.aliexpress.com/item/1005002971655457.html"]}, {"id": "E18", "phase": "1", "item": "Cabinet filter fan + exhaust grille (9803 series)", "qty": "1 set", "price": "22.33", "vendor": "AliExpress", "url": "https://www.aliexpress.com/item/1005003027013500.html", "extra": ["https://www.aliexpress.com/item/32884649030.html"]}, {"id": "E21", "phase": "1", "item": "Reset button 22 mm green (in your basket)", "qty": "1 pcs", "price": "4.25", "vendor": "AliExpress", "url": "https://www.aliexpress.com/item/1005006872683640.html", "extra": []}, {"id": "N01", "phase": "2", "item": "Enclosure box: 12 mm MDF (B&Q)", "qty": "2 sheets", "price": "46.00", "vendor": "B&Q", "url": "https://www.diy.com/departments/mdf-board-l-2-44m-w-1-22m-t-12mm-22130g/1696260_BQ.prd", "extra": []}, {"id": "N02", "phase": "2", "item": "Enclosure window: 4 mm solid clear polycarbonate", "qty": "1 pcs", "price": "29.87", "vendor": "plasticsheets.com", "url": "https://www.plasticsheets.com/clear-polycarbonate/", "extra": []}, {"id": "N03", "phase": "2", "item": "LED light", "qty": "1 pcs", "price": "2.74", "vendor": "AliExpress", "url": "https://www.aliexpress.com/item/1005013221981188.html", "extra": []}, {"id": "T02", "phase": "1", "item": "Anti-vibration feet", "qty": "4 pcs", "price": "12.19", "vendor": "RS Components", "url": "https://uk.rs-online.com/web/p/adjustable-feet/0285757", "extra": []}, {"id": "X01", "phase": "1", "item": "Dial test indicator + magnetic base", "qty": "1 set", "price": "17.23", "vendor": "AliExpress", "url": "https://www.aliexpress.com/item/1005013036061506.html", "extra": []}, {"id": "X02", "phase": "1", "item": "Precision level 200 mm (AliExpress)", "qty": "1 pcs", "price": "32.94", "vendor": "AliExpress", "url": "https://www.aliexpress.com/item/32814850915.html", "extra": []}, {"id": "X03", "phase": "1", "item": "Socket cap screws (M5/M6/M8/M10/M12)", "qty": "1 lot", "price": "70.47", "vendor": "Screwfix", "url": "https://www.screwfix.com/", "extra": ["https://www.aliexpress.com/item/4000784829771.html"]}]""")
NEEDS_VENDOR = json.loads(r"""[]""")

def firefox_cmd():
    found = shutil.which("firefox")
    if found:
        return found
    for c in (r"C:\Program Files\Mozilla Firefox\firefox.exe",
              r"C:\Program Files (x86)\Mozilla Firefox\firefox.exe",
              os.path.expandvars(r"%LOCALAPPDATA%\Mozilla Firefox\firefox.exe"),
              "/Applications/Firefox.app/Contents/MacOS/firefox"):
        if os.path.exists(c):
            return c
    return None

def open_tabs(ff, urls, batch=10):
    for i in range(0, len(urls), batch):
        chunk = urls[i:i + batch]
        if ff:
            args = [ff]
            for u in chunk:
                args += ["--new-tab", u]
            subprocess.Popen(args)
        else:
            for u in chunk:
                webbrowser.open_new_tab(u)
        time.sleep(1.5)

def main():
    ap = argparse.ArgumentParser()
    ap.add_argument("--phase", default="1")
    ap.add_argument("--with-alts", action="store_true")
    ap.add_argument("--list", action="store_true")
    a = ap.parse_args()
    phases = {"1", "2", "3"} if a.phase == "all" else set(a.phase.split(","))
    parts = [p for p in PARTS if p["phase"] in phases]
    vendors = {}
    for p in parts:
        vendors.setdefault(p["vendor"], []).append(p)
    order = sorted(vendors, key=lambda v: -len(vendors[v]))
    print(f"Phase {a.phase}: {len(parts)} parts from {len(order)} vendors: " + ", ".join(order))
    need = [f"{m['id']} {m['item']}" for m in NEEDS_VENDOR if m["phase"] in phases]
    if need:
        print("Still need a non-eBay source (not opened): " + "; ".join(need))
    ff = firefox_cmd()
    if not ff and not a.list:
        print("Firefox not found: using the default browser.")
    for n, v in enumerate(order, 1):
        items = vendors[v]
        total = sum(float(p["price"]) for p in items if p["price"])
        print(f"\n=== {n}/{len(order)}  {v}  ({len(items)} parts, about £{total:,.2f}) ===")
        urls = []
        for p in items:
            print(f"  {p['id']:4s} {p['qty']:>14s}  {p['item']}")
            if p["url"] not in urls:
                urls.append(p["url"])
            if a.with_alts:
                urls += [u for u in p["extra"] if u not in urls]
        if a.list:
            for u in urls:
                print(f"       {u}")
            continue
        open_tabs(ff, urls)
        ans = input(f"Add these to the {v} basket, close the product tabs, then press Enter for the next vendor (q = quit): ").strip().lower()
        if ans == "q":
            break
    print("\nDone.")
    return 0

if __name__ == "__main__":
    sys.exit(main())
