yousef-chitani/Type_0_CNC/(commit log)

2026-11-04 Record Z travel, ballscrew, rail and rail-seat decisions
    Claude-Session: https://claude.ai/code/session_01LVLoxd2CNyp1vyTKkJiN47
2026-11-04 Record screw, coupling, motor and Z-brake decisions; flag rack pitch issue
    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
2026-11-04 Record rail layout, Z construction and table decisions
    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
2026-11-04 Add EG mould diagrams, mould/demould assessment and UK epoxy comparison
    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
2026-11-04 Switch to solid EG castings; update masses, diagrams, epoxy quantity and add thermal checklist
    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
2026-11-04 Record e-stop, drive PSU, cabinet and spindle cooling decisions
    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
2026-11-04 Add parts list (specs and quantities, no prices yet)
    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
    [bom.csv]
2026-11-04 Pin spindle to Jianken JGL-80/2.2R24-20
    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
    [bom.csv]
2026-11-04 BOM: ER16 holders, candidate stepper kit, 10 mm coupling, flag Z brake motor and price access
    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
    [bom.csv]
2026-11-04 BOM: add links to every row, pick Z brake motor, add Z driver row
    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
    [bom.csv]
2026-11-04 BOM: add clickable link table to bom.md
    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
2026-11-04 BOM: add 9 prices confirmed from live supplier pages, price warnings
    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
    [bom.csv]
2026-11-05 BOM: add 60 prices from local browser check; totals and warnings
    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
    [bom.csv]
2026-11-05 Switch to 0.05 mm/m level, add price-check task 2 (savings and missing costs)
    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
    [bom.csv]
2026-11-05 BOM: apply price-check 2 (savings and missing costs), total about £5,389
    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
    [bom.csv]
2026-11-05 BOM: GCL quartz aggregates, accept MDF and B&Q sand, split build into two stages
    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
    [bom.csv]
2026-11-05 Add price-check task 3 (AliExpress savings for Stage 1)
    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
2026-11-05 BOM: AliExpress check; VFD with RS-485 Modbus at £88.94
    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
    [bom.csv]
2026-11-05 Add parametric CadQuery layout, dimensioned drawings, layout notes; update BOM lengths
    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
    [bom.csv, type0.step]
2026-11-05 Stand 60x60x3 braced, cabinet 600x400x200 inside; price-check task 4
    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
    [bom.csv, type0.step]
2026-11-05 BOM: price check 4 (new sizes); Y-screw channel in base
    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
    [bom.csv]
2026-11-05 Set budget: Stage 1 £5,300, Stage 2 £600
    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
2026-11-05 Fix stale item names in BOM; regenerate review list
    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
    [bom.csv]
2026-11-05 Owner cuts: own PC/monitor, printed forks, no NIC or USB-RS485; DIN PSUs; MDF floors + gloss panel walls; Mesa €309.31
    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
    [bom.csv]
2026-11-05 BOM: NDR-480-48 and 5 V DIN PSU from owner basket (£153.60)
    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
    [bom.csv]
2026-11-05 BOM: 5 V PSU is Mean Well MDR-10-5
    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
    [bom.csv]
2026-11-05 BOM: Mesa £257.74, vibration table rubber feet £19.80; all lines priced
    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
    [bom.csv]
2026-11-05 Fix stage note wording
    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
2026-11-05 Aggregates sourcing doc (Gravel Works Swansea); record Mesa VAT paid and Jianken order
    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
    [bom.csv]
2026-11-05 Aggregates: GCL quartz coarse + Hancock & Brown kiln-dried sand and limestone dust
    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
    [bom.csv]
2026-11-05 Filler: pottery whiting instead of limestone dust
    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
    [bom.csv]
2026-11-05 Three phases (ER20 spindle first), casting/cooling/stand cuts, UHPC costed and rejected; price-check task 5
    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
    [bom.csv]
2026-11-05 BOM: price check 5 (ER20 spindle, collets, 24 V cooling loop, 8 m stand); Phase 1 £3,638
    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
    [bom.csv]
2026-11-05 Phase 1 spindle: Jianken JGD-80 ER20 (to quote); Phase 1 cost sheet
    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
    [bom.csv]
2026-11-06 Scale-down brief: compare modular EG vs steel frame with sand fill
    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
2026-11-06 v2 scale-down: 3-piece cast frame concept sketch, side rack on table
    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
2026-11-06 v2 concept rev B: legs span table, beam overhang, edge-on ferris-wheel ATC
    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
2026-11-06 v2 parametric model, design notes (joints, ATC wheel), BOM resized for v2
    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
    [bom.csv, type0_v2.step]
2026-11-06 v2: cast spine and rear foot as one T-shaped base (about 52 kg)
    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
    [type0_v2.step]
2026-11-06 DIY tyre vibration table; drop rubber feet
    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
    [bom.csv]
2026-11-07 BOM: price check 6 (v2 rails, plates, feet, MDF enclosure, ATC wheel parts)
    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
    [bom.csv]
2026-11-07 Phase 1 spindle: G-Penny 2.2 kW ER20 kit (spindle, Huanyang VFD, clamp, pump, collets)
    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
    [bom.csv]
2026-11-07 G-Penny kit shipping £100.77; Phase 1 fully priced
    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
    [bom.csv]
2026-11-07 Phase 1 parts spreadsheet with prices, links and tracking columns
    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
    [phase1-bom.xlsx]
2026-11-07 Phase 1 spreadsheet: clickable HYPERLINK cells, extra supplier links in their own columns
    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
    [phase1-bom.xlsx]
2026-11-07 Work area 400 x 250 (D-79), Y rails 280 on 320 spine (D-80); BOM resized; price-check task 7
    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
    [bom.csv, type0_v2.step]
2026-11-07 Price check 7 (800 X rails, 750 X screw, 460x330 table, enclosure MDF); Phase 1 £3,065
    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
    [bom.csv, phase1-bom.xlsx]
2026-11-08 Sketch rev D (400 x 250) and tools/open_links.py to open BOM links in Firefox
    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
2026-11-08 open_links.py: standalone with built-in links (reads bom.csv when present)
    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
2026-11-08 open_links.py: vendor-by-vendor shopping with a pause between vendors, no eBay; builder script; fix stale item names
    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
    [bom.csv, phase1-bom.xlsx]
2026-11-08 Price check 8: current prices, delta/premium rule, rod/nuts/conduit/tape to AliExpress (D-83)
    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
2026-11-08 Apply vendor consolidation (price check 8): 12 Phase 1 vendors, no eBay; owner premium decisions (D-84)
    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
    [bom.csv, phase1-bom.xlsx]
2026-11-08 Price check 9 applied: all lines priced, no eBay (D-85)
    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
    [bom.csv, phase1-bom.xlsx]
2026-11-08 Merge Phase 3 (ATC wheel) into Phase 2 (D-86)
    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
    [bom.csv]
2026-11-08 Model the enclosure: MDF box, top-hinged door with window, cut list (D-87)
    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
    [bom.csv, type0_v2_with_enclosure.step]
2026-11-08 Enclosure window: 4 mm solid polycarbonate 600 x 420 (D-88)
    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
    [bom.csv]
2026-11-08 Enclosure MDF from B&Q (D-89)
    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
    [bom.csv]
2026-11-08 Fix: Mesa price includes import VAT, not already bought
    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
    [bom.csv, phase1-bom.xlsx]
2026-11-08 Task 1: electrical design (power, safety chain, 7I76EU pin map, VFD settings); E23 pump relay; 5 V PSU shelved
    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
    [bom.csv]
2026-11-08 Handover: HANDOVER.md, updated open questions, BOM generator scripts moved into tools/
    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
    [phase1-bom.xlsx]
